Jabooby/Aeris-Control/README.md

# AERISCONTROL
Autonomous sail boat with a multiaxial sail control
