Jabooby/Aeris-Control/UI/README.txt

# Node-RED Flow Import Instructions

This project contains a `flows.json` file that you can import into your own Node-RED environment to replicate the flow and dashboard UI.

Step 1: Run Node-RED

Step 2: http://localhost:1880 OR http://<your-raspberry-pi-IP>:1880

Step 3:click the menu icon in the top right corner (☰)

Step 4: Click on "Import"

Step 5: Click the flows.json file found in this directory
