Jabooby/Aeris-Control/Code/Rp2350/Stepper_control/Diagramme classe.png

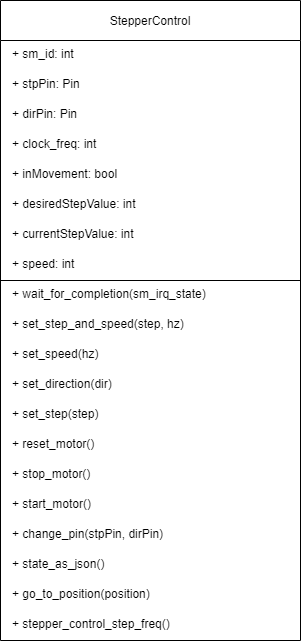
Code/Rp2350/Stepper_control/Diagramme classe.png
