Jabooby/Aeris-Control/Electric/Aeris control electrical plans/Proto_V1/A4988_DRIVER_CARRIER/A4988_STEPPER_MOTOR_DRIVER_CARRIER.step

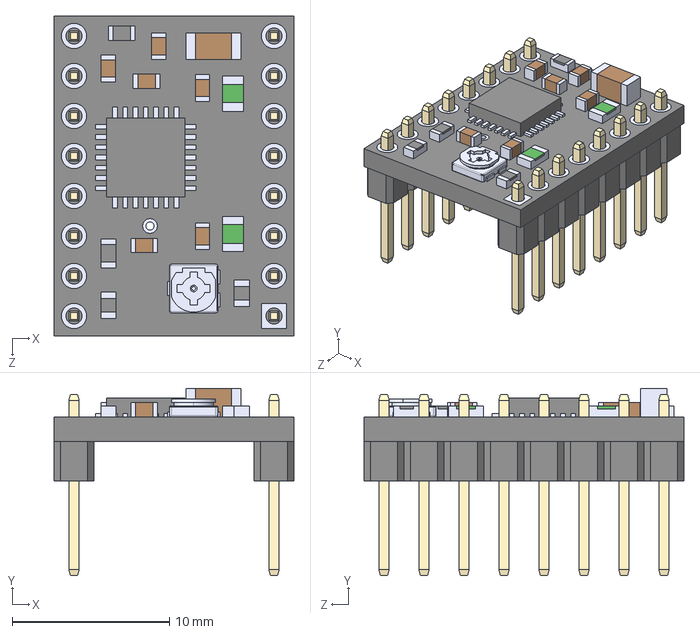
[picture p2: CAD file, 2025-01-29]
Electric/Aeris control electrical plans/Proto_V1/A4988_DRIVER_CARRIER/A4988_STEPPER_MOTOR_DRIVER_CARRIER.step
15.2 x 11.9 x 20.3 mm
