Jabooby/Aeris-Control/Electric/Aeris control electrical plans/symbols/RP2350_KiCad-main/RP2350A-QFN60.step

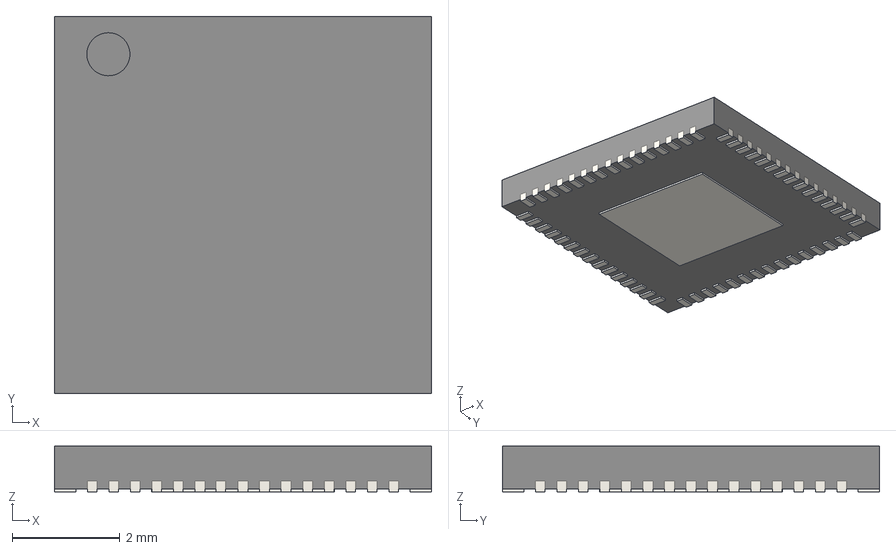
[picture p3: CAD file, 2025-03-01]
Electric/Aeris control electrical plans/symbols/RP2350_KiCad-main/RP2350A-QFN60.step
7.00 x 7.00 x 0.85 mm
