Jabooby/Aeris-Control/Electric/Aeris control electrical plans/symbols/RP2350_KiCad-main/RP2350B-QFN80.step

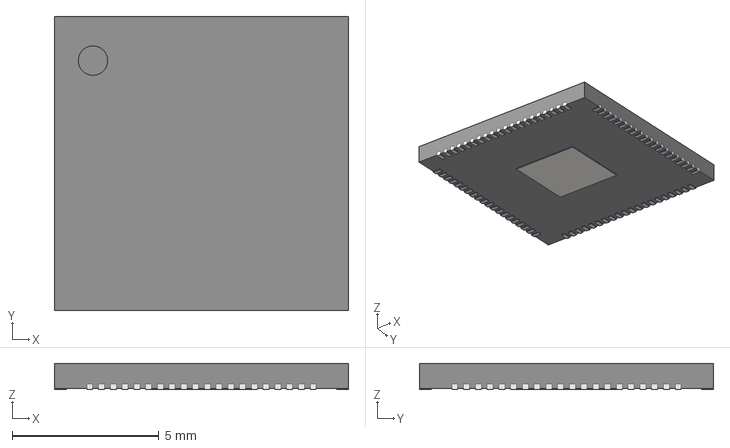
[picture p4: CAD file, 2025-03-01]
Electric/Aeris control electrical plans/symbols/RP2350_KiCad-main/RP2350B-QFN80.step
10.0 x 10.0 x 0.9 mm
