Jabooby/Aeris-Control/Mécanique/Archives/Sail/Sail Shell/Airfoil/airfoil_assembly.stl

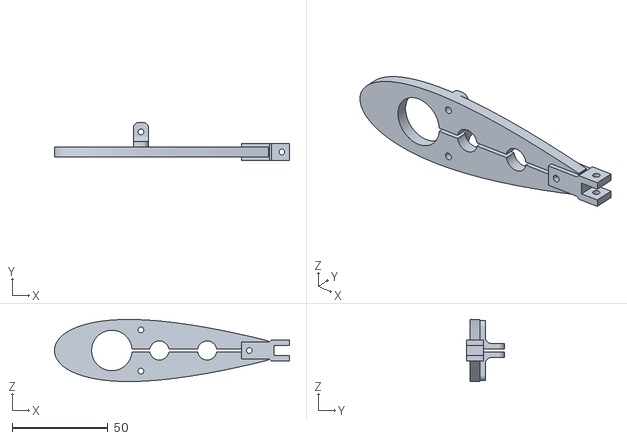
[picture p5: CAD file, 2025-04-02, an earlier design]
Mécanique/Archives/Sail/Sail Shell/Airfoil/airfoil_assembly.stl
123.0 x 20.0 x 32.5
