Jabooby/Aeris-Control/Mécanique/Archives/Fin/Roller_assembly.stl

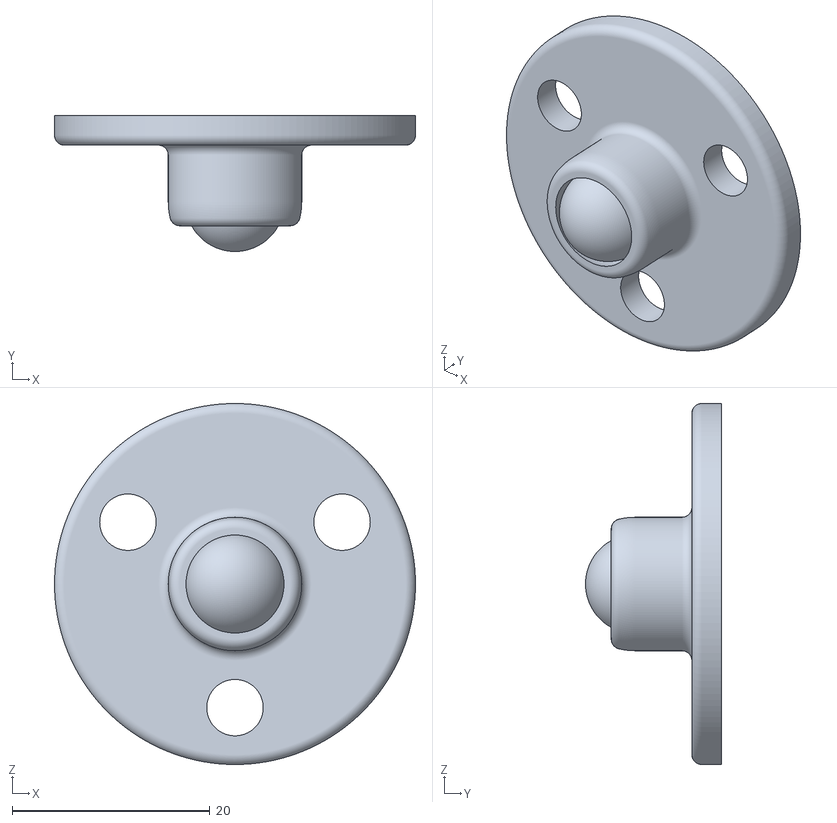
[picture p6: CAD file, 2025-04-02, an earlier design]
Mécanique/Archives/Fin/Roller_assembly.stl
36.5 x 13.8 x 36.5
