Jabooby/Aeris-Control/Mécanique/Archives/Body/Wood_Plank.stl

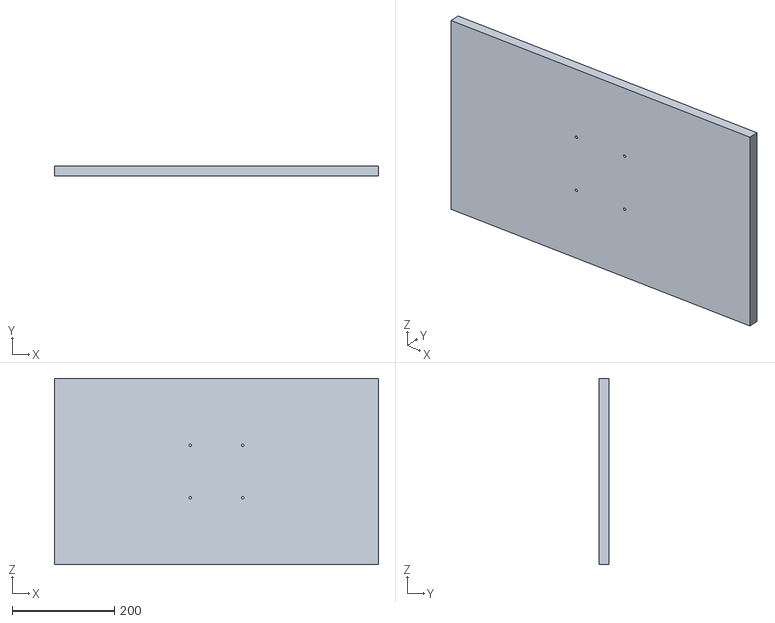
[picture p7: CAD file, 2025-04-02, an earlier design]
Mécanique/Archives/Body/Wood_Plank.stl
635.0 x 19.1 x 365.0
