Jabooby/Aeris-Control/Mécanique/Archives/Electronics_Casing/Floor_1.stl

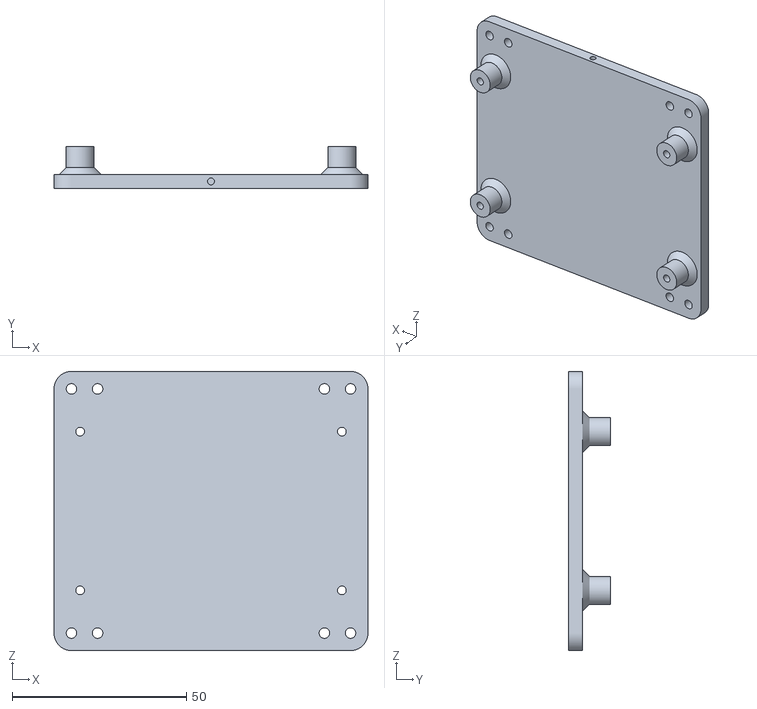
[picture p8: CAD file, 2025-04-02, an earlier design]
Mécanique/Archives/Electronics_Casing/Floor_1.stl
90.0 x 12.0 x 80.0
