Jabooby/Aeris-Control/Mécanique/Archives/Fin/Ball_Holder.stl

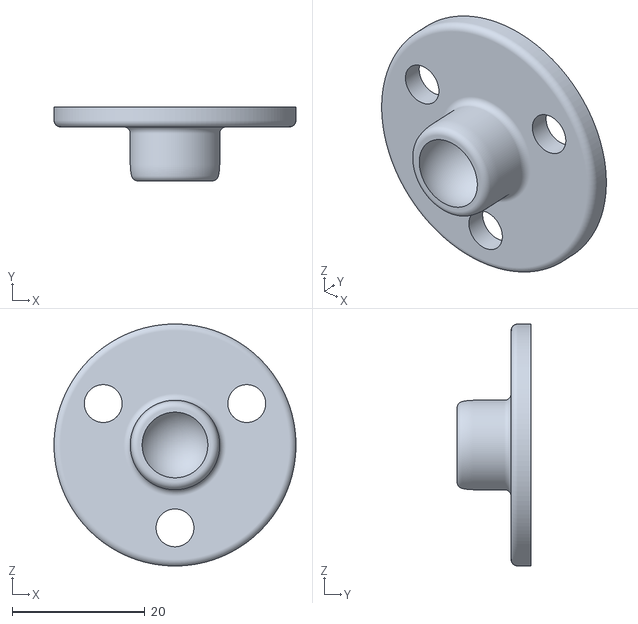
[picture p9: CAD file, 2025-04-02, an earlier design]
Mécanique/Archives/Fin/Ball_Holder.stl
36.5 x 11.2 x 36.5
