Jabooby/Aeris-Control/Mécanique/Archives/IMU_Support/IMU_Casing_Bracket.stl

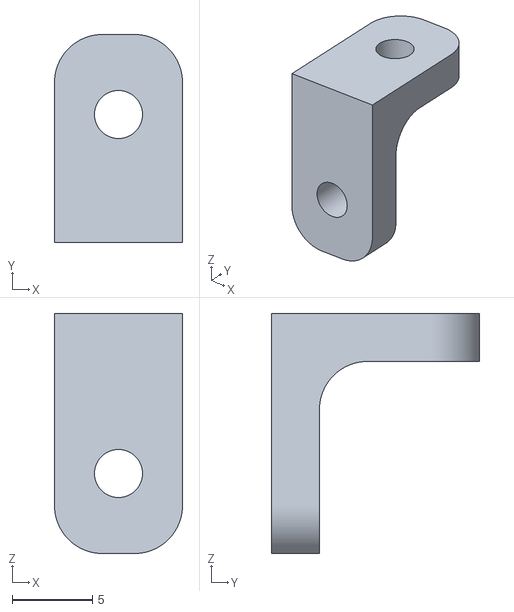
[picture p10: CAD file, 2025-04-02, an earlier design]
Mécanique/Archives/IMU_Support/IMU_Casing_Bracket.stl
8.00 x 13.0 x 15.0
