Jabooby/Aeris-Control/Mécanique/Archives/Mast Holder/Motor_Casing/Motor_Casing.stl

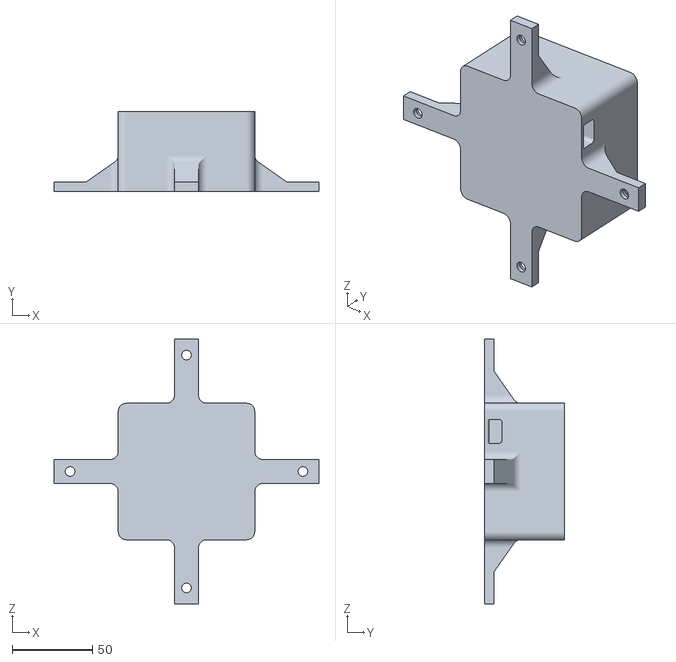
[picture p11: CAD file, 2025-04-02, an earlier design]
Mécanique/Archives/Mast Holder/Motor_Casing/Motor_Casing.stl
165.0 x 50.0 x 165.0
