Jabooby/Aeris-Control/Mécanique/Archives/Mast Holder/Planetary_Gear/(old)Straight_Planetary/Ring.stl

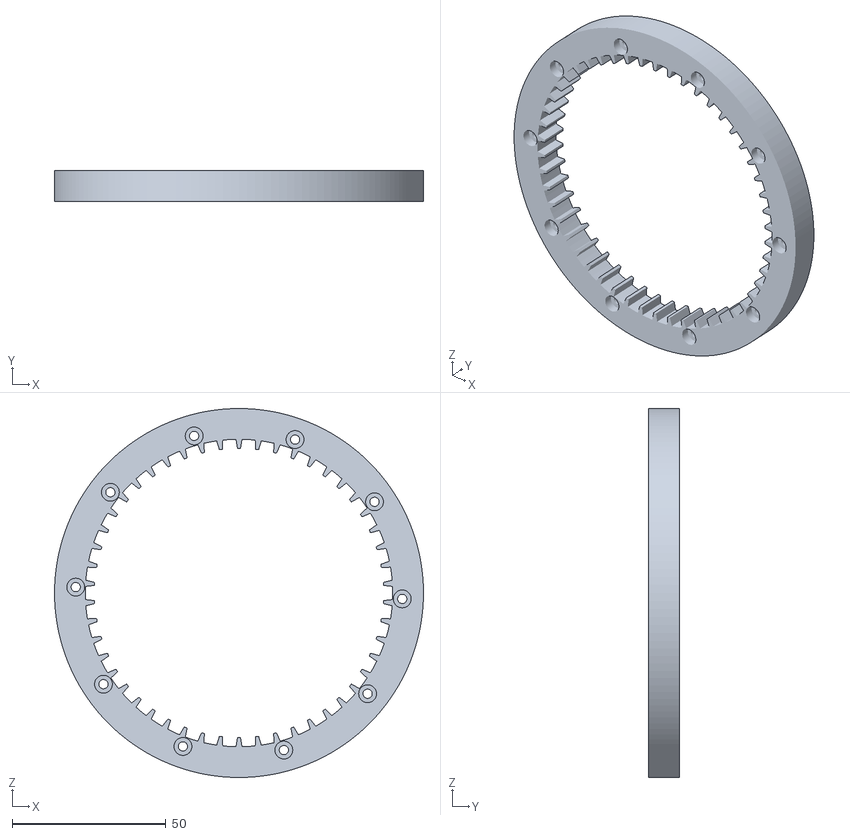
[picture p12: CAD file, 2025-04-02, an earlier design]
Mécanique/Archives/Mast Holder/Planetary_Gear/(old)Straight_Planetary/Ring.stl
120.0 x 10.0 x 120.0
