Jabooby/Aeris-Control/Mécanique/Archives/Mast Holder/Planetary_Gear/Conic_Planetary/ConicGears - Planet.stl

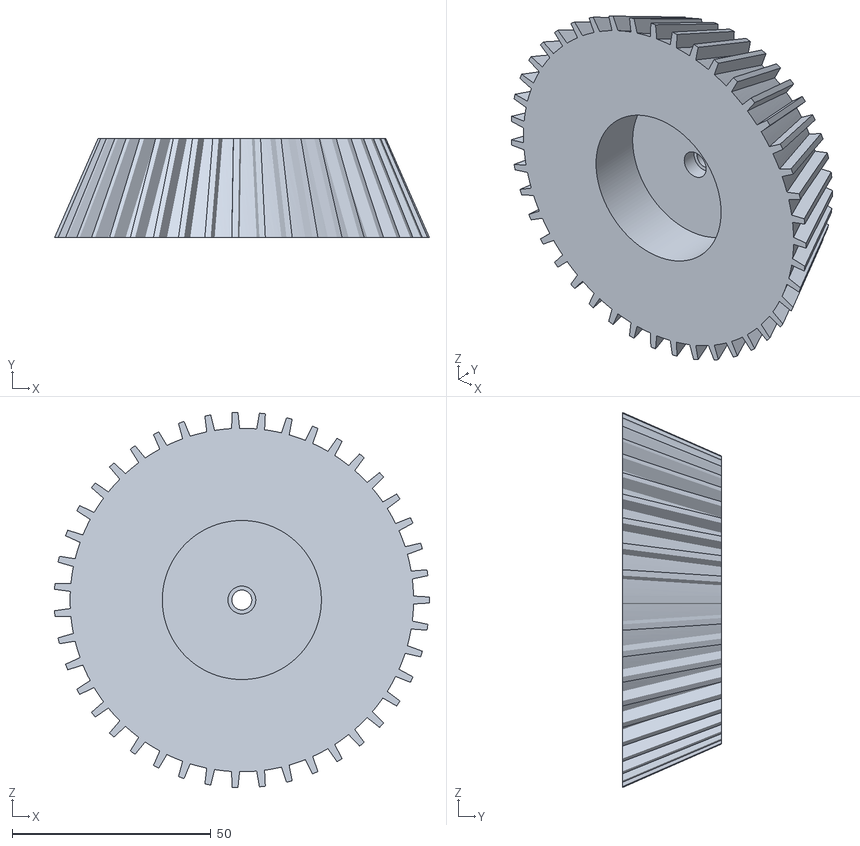
[picture p13: CAD file, 2025-04-02, an earlier design]
Mécanique/Archives/Mast Holder/Planetary_Gear/Conic_Planetary/ConicGears - Planet.stl
94.3 x 25.0 x 94.4
