Jabooby/Aeris-Control/Mécanique/Archives/Mast Holder/Universtal_Joint(Joystick)/Cross.stl

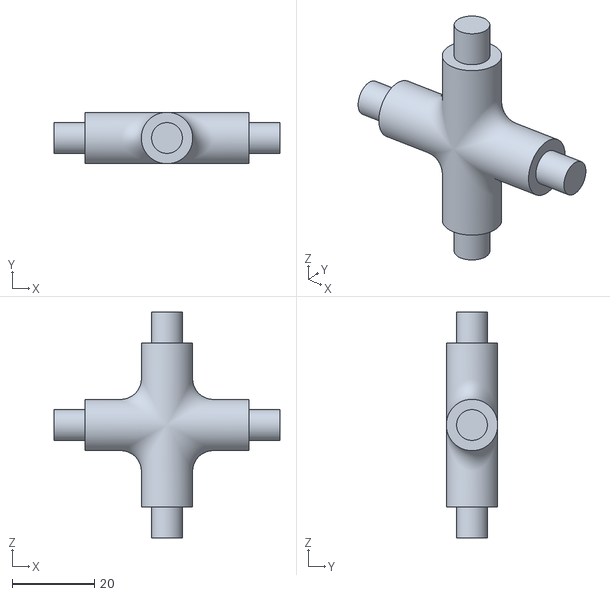
[picture p14: CAD file, 2025-04-02, an earlier design]
Mécanique/Archives/Mast Holder/Universtal_Joint(Joystick)/Cross.stl
55.0 x 12.5 x 55.0
