Jabooby/Aeris-Control/Mécanique/Archives/Rope System/(old)Winch-Pulley system/Guides/Rope holder.stl

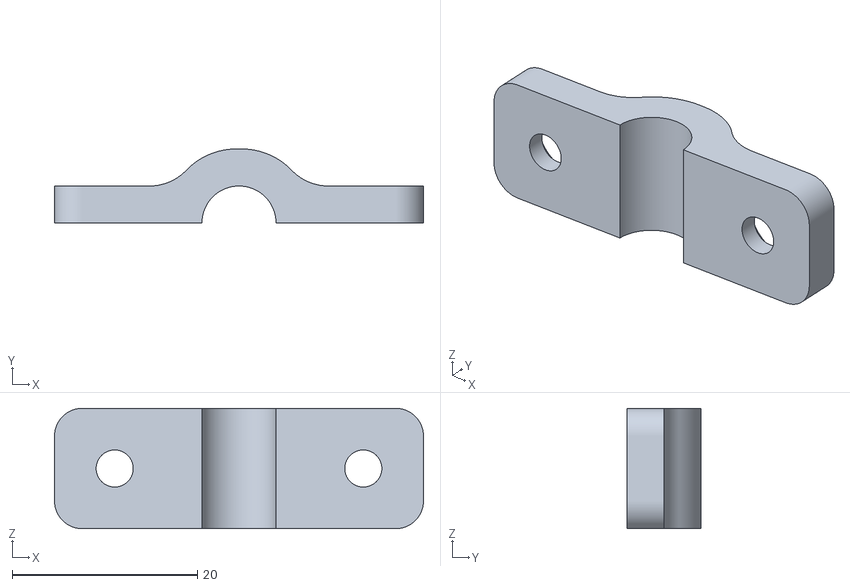
[picture p15: CAD file, 2025-04-02, an earlier design]
Mécanique/Archives/Rope System/(old)Winch-Pulley system/Guides/Rope holder.stl
39.9 x 8.00 x 13.0
