Jabooby/Aeris-Control/Mécanique/Archives/Rope System/(old)Winch-Pulley system/Pulley Parts/Rope_Guide_For_Pulley.stl

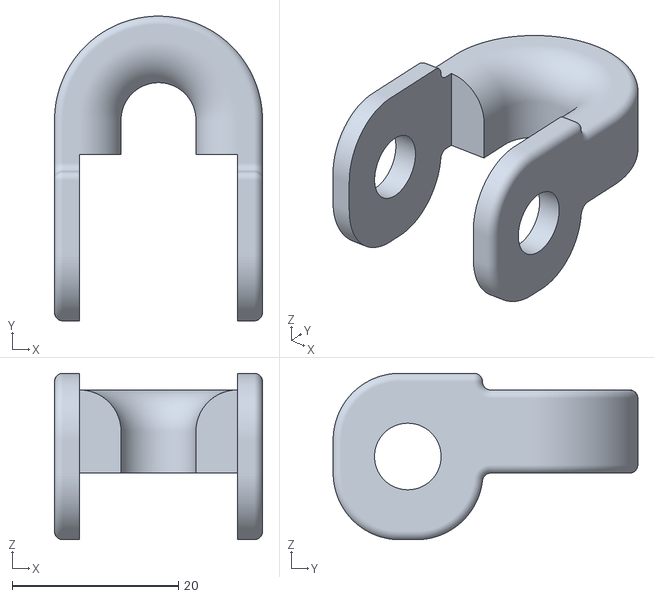
[picture p16: CAD file, 2025-04-02, an earlier design]
Mécanique/Archives/Rope System/(old)Winch-Pulley system/Pulley Parts/Rope_Guide_For_Pulley.stl
25.0 x 36.6 x 20.0
