Jabooby/Aeris-Control/Mécanique/Archives/Rope System/(old)Winch-Pulley system/Spring_pulley/Rope_Guide_For_Pulley.stl

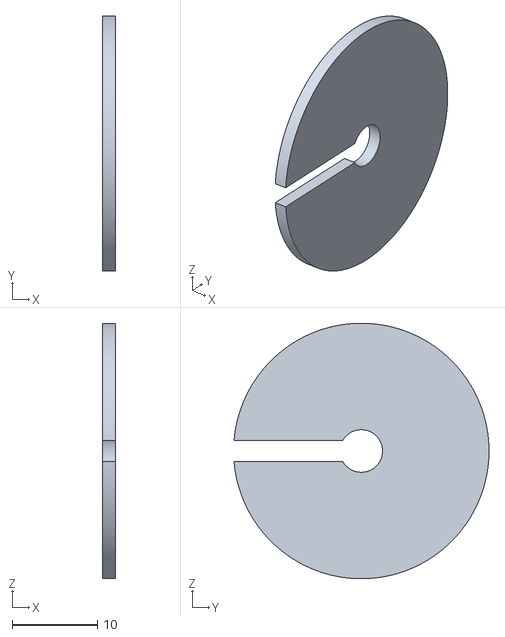
[picture p17: CAD file, 2025-04-02, an earlier design]
Mécanique/Archives/Rope System/(old)Winch-Pulley system/Spring_pulley/Rope_Guide_For_Pulley.stl
1.50 x 29.9 x 30.0
