Jabooby/Aeris-Control/Mécanique/Archives/Rope System/(old)Winch-Pulley system/Winch/Drums/Drum_Large.stl

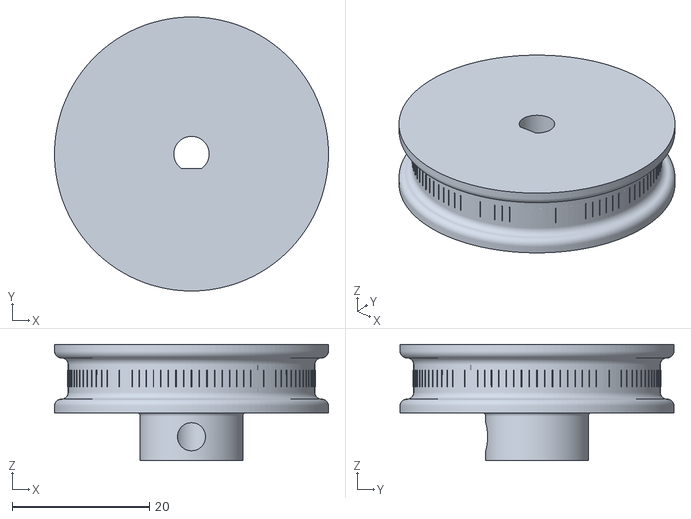
[picture p18: CAD file, 2025-04-02, an earlier design]
Mécanique/Archives/Rope System/(old)Winch-Pulley system/Winch/Drums/Drum_Large.stl
40.0 x 40.0 x 17.0
