Jabooby/Aeris-Control/Mécanique/Archives/Rope System/(old)Winch-Pulley system/Winch/Motor_Bracket.stl

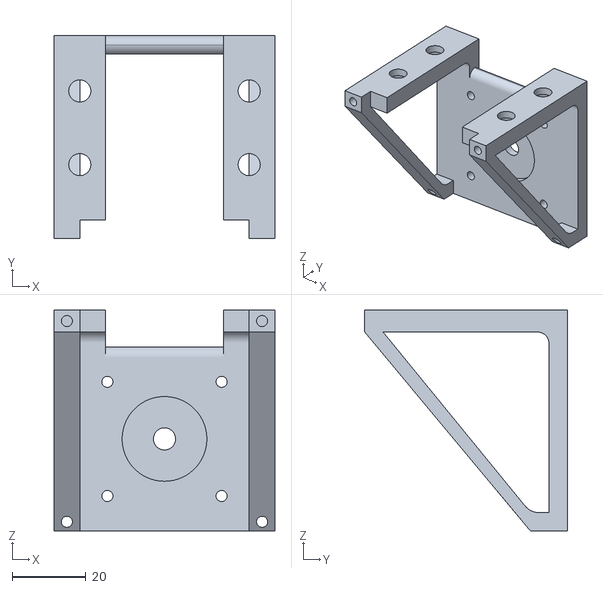
[picture p19: CAD file, 2025-04-02, an earlier design]
Mécanique/Archives/Rope System/(old)Winch-Pulley system/Winch/Motor_Bracket.stl
60.0 x 55.0 x 60.0
