Jabooby/Aeris-Control/(list of files, cad)

Other CAD files:
Mécanique/Archives/Electronics_Casing/Battery_Holder.stl
Mécanique/Archives/Electronics_Casing/Buck_Converter_Bracket.stl
Mécanique/Archives/Electronics_Casing/Floor_0.stl
Mécanique/Archives/Electronics_Casing/Floor_2.stl
Mécanique/Archives/Electronics_Casing/Spacer.stl
Mécanique/Archives/Fin/Fin_representation.stl
Mécanique/Archives/IMU_Support/IMU_Casing.stl
Mécanique/Archives/Mast Holder/Planetary_Gear/(old)Straight_Planetary/Planet.stl
Mécanique/Archives/Mast Holder/Planetary_Gear/(old)Straight_Planetary/Sun.stl
Mécanique/Archives/Mast Holder/Planetary_Gear/Conic_Planetary/ConicGears - Coupler.stl
Mécanique/Archives/Mast Holder/Planetary_Gear/Conic_Planetary/ConicGears - Sun.stl
Mécanique/Archives/Mast Holder/Planetary_Gear/Conic_Planetary/Gearbox_Base.stl
Mécanique/Archives/Mast Holder/Universtal_Joint(Joystick)/Universal_Joint_Bearing.stl
Mécanique/Archives/Rope System/(old)Winch-Pulley system/Pulley Parts/Bolt_representation.stl
Mécanique/Archives/Rope System/(old)Winch-Pulley system/Pulley Parts/Pulley.stl
Mécanique/Archives/Rope System/(old)Winch-Pulley system/Pulley Parts/Pulley_Support_Negative_Angle.stl
Mécanique/Archives/Rope System/(old)Winch-Pulley system/Pulley Parts/Pulley_Support_Positive_Angle.stl
Mécanique/Archives/Rope System/(old)Winch-Pulley system/Spring_pulley/Rope_Pulley.stl
Mécanique/Archives/Rope System/(old)Winch-Pulley system/Spring_pulley/Spring to board.stl
Mécanique/Archives/Rope System/(old)Winch-Pulley system/Winch/Drums/Drum_for_Motor_V_Shape.stl
Mécanique/Archives/Rope System/(old)Winch-Pulley system/Winch/Motor pulley guide.stl
Mécanique/Archives/Rope System/Winch-Spring system/Gearbox/Case/Left_Box.stl
Mécanique/Archives/Rope System/Winch-Spring system/Gearbox/Case/Left_Cover.stl
Mécanique/Archives/Rope System/Winch-Spring system/Gearbox/Case/Right_Box.stl
Mécanique/Archives/Rope System/Winch-Spring system/Gearbox/Case/Right_Cover.stl
Mécanique/Archives/Rope System/Winch-Spring system/Gearbox/Drum.stl
Mécanique/Archives/Rope System/Winch-Spring system/Gearbox/Gears/Driven.stl
Mécanique/Archives/Rope System/Winch-Spring system/Gearbox/Gears/Driver.stl
Mécanique/Archives/Rope System/Winch-Spring system/Gearbox/Gears/Idle.stl
Mécanique/Archives/Rope System/Winch-Spring system/Gearbox/Shaft_modelisation.stl
Mécanique/Archives/Rope System/Winch-Spring system/Gearbox/Spacer.stl
Mécanique/Archives/Sail/Sail Shell/Airfoil/airfoil.stl
Mécanique/Archives/Sail/Sail Shell/Attachement brackets/Airfoil_Batten_Connector.stl
Mécanique/Archives/Sail/Sail Shell/Attachement brackets/Batten_Leech_Connector.stl
Mécanique/Archives/Sail/Sail Shell/Attachement brackets/Mast_Leech_Connector.stl
Mécanique/Archives/Sail/Sail Shell/Battens/Batten_1_smallest.stl
Mécanique/Archives/Sail/Sail Shell/Battens/Batten_2.stl
Mécanique/Archives/Sail/Sail Shell/Battens/Batten_3.stl
Mécanique/Archives/Sail/Sail Shell/Battens/Batten_4.stl
Mécanique/Archives/Sail/Sail Shell/Battens/Batten_5.stl
Mécanique/Archives/Sail/Sail Shell/Leech/angled_leech_wood.stl
Mécanique/Archives/Sail/Sail Shell/Leech/angled_leech_wood_bottom.stl
Mécanique/Archives/Sail/Sail Shell/Leech/angled_leech_wood_top.stl
Mécanique/Archives/Sail/mast.stl
Mécanique/Archives/Wind mesurement/Casing/Bearing saddle.stl
Mécanique/Archives/Wind mesurement/Casing/Bearing.stl
Mécanique/Archives/Wind mesurement/Casing/Encoder_Representation.stl
Mécanique/Archives/Wind mesurement/Heads/Wheather_Vane_Head.stl
