Jabooby/Aeris-Control/Code/Rp2350/Stepper_control/fonction assembly.png

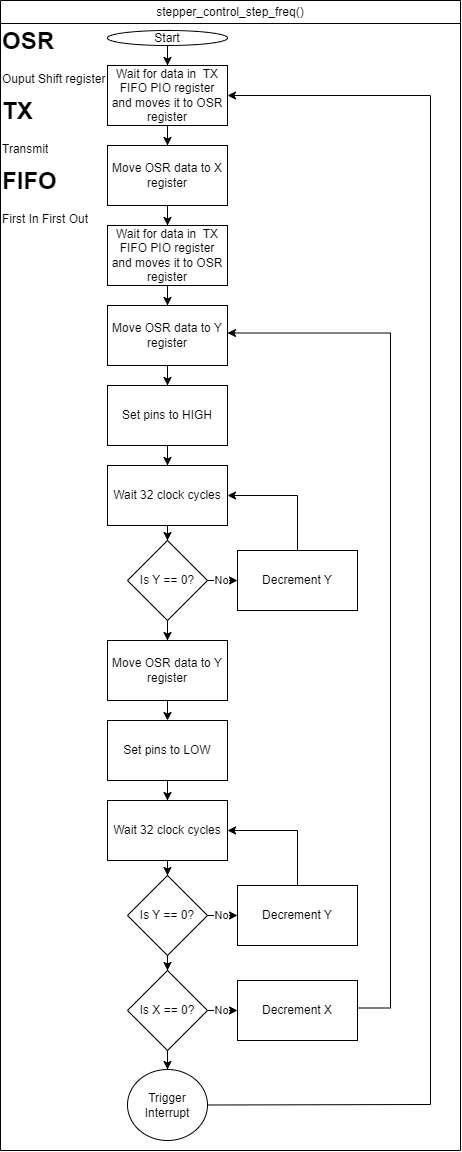
Code/Rp2350/Stepper_control/fonction assembly.png
