Jabooby/Aeris-Control/Electric/Aeris control schematic.pdf

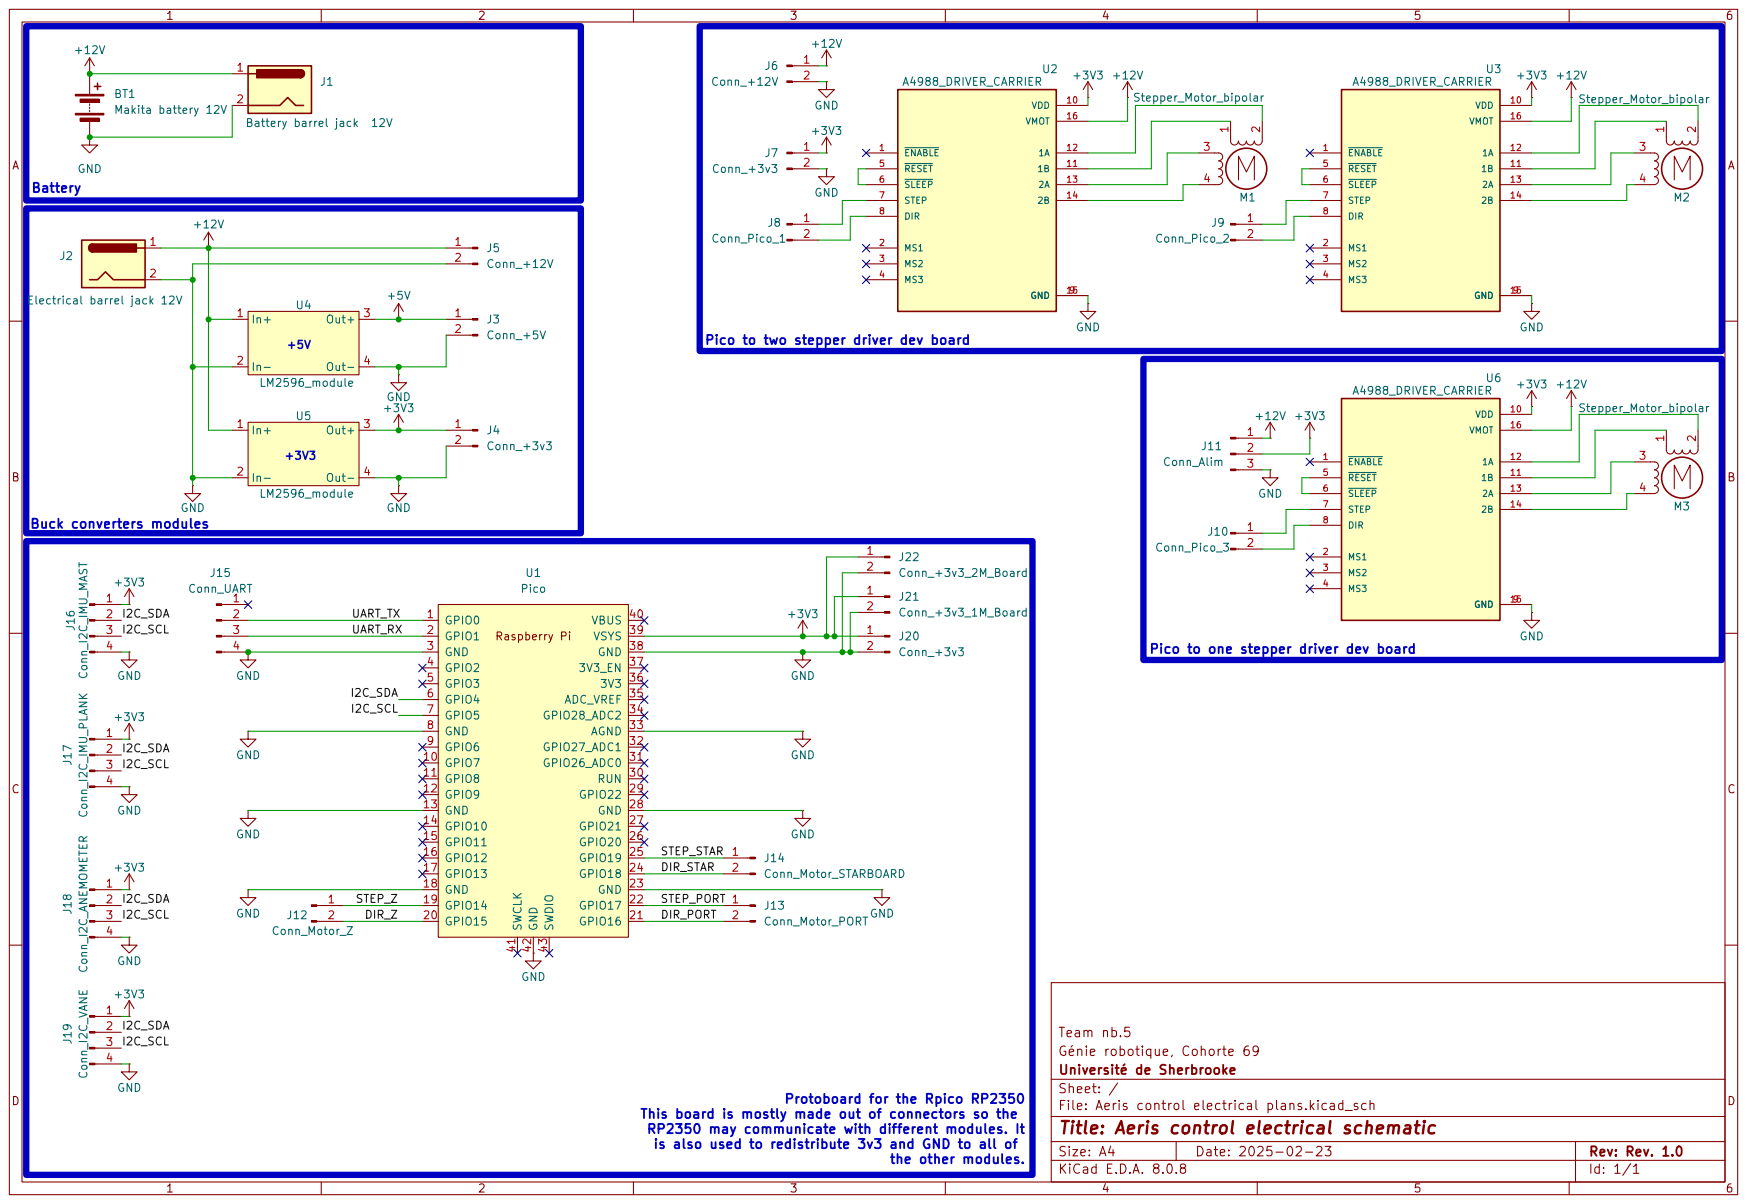
[picture p21: page 1]
