Jabooby/Aeris-Control/Mécanique/Archives/Sail/Sail Shell/wood_laser_cut_800mm.pdf

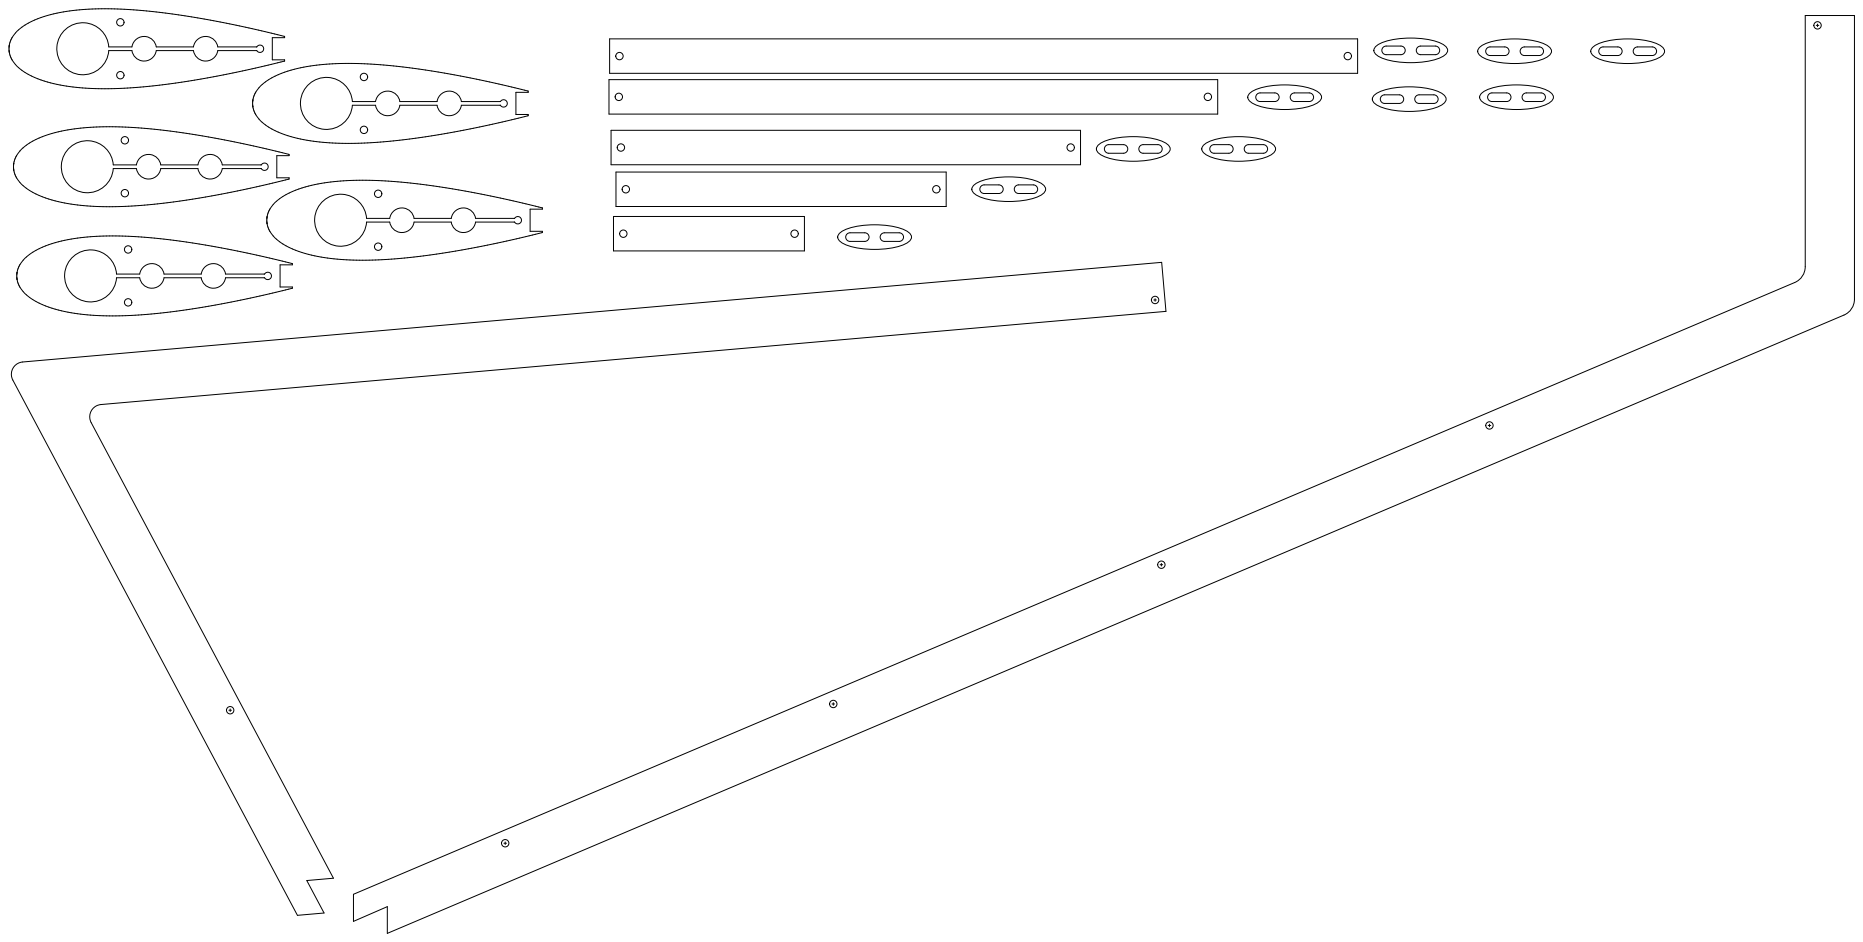
[picture p22: page 1]
