Jabooby/Aeris-Control/Electric/Aeris control electrical plans/Cerbrum_Aeris/Cerbrum_Aeris.kicad_pcb

## KiCad design Electric/Aeris control electrical plans/Cerbrum_Aeris/Cerbrum_Aeris.kicad_pcb (2025-03-12)

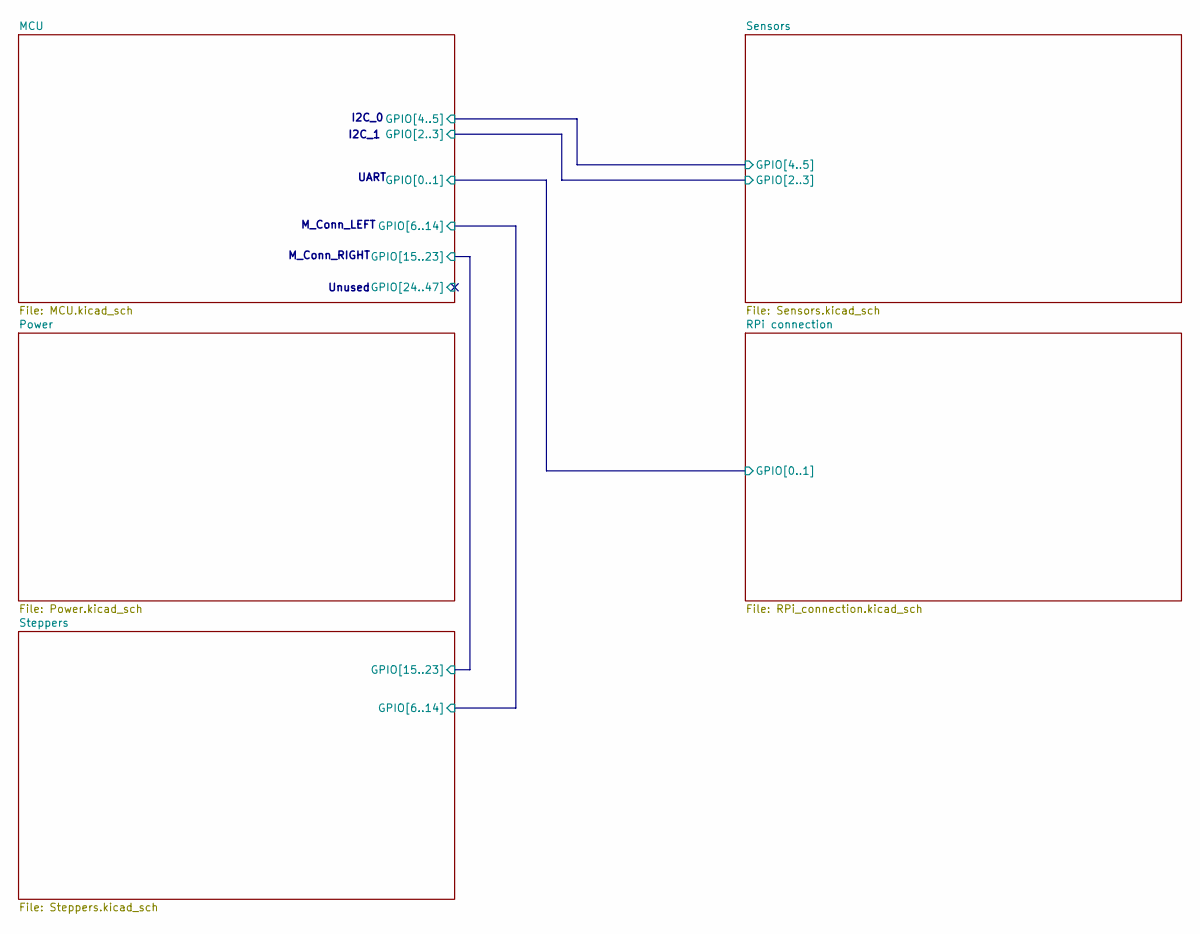
[picture p23: schematic Cerbrum_Aeris.kicad_sch]

Notes on the sheet:
Unused
I2C_1
M_Conn_RIGHT
I2C_0
UART
M_Conn_LEFT

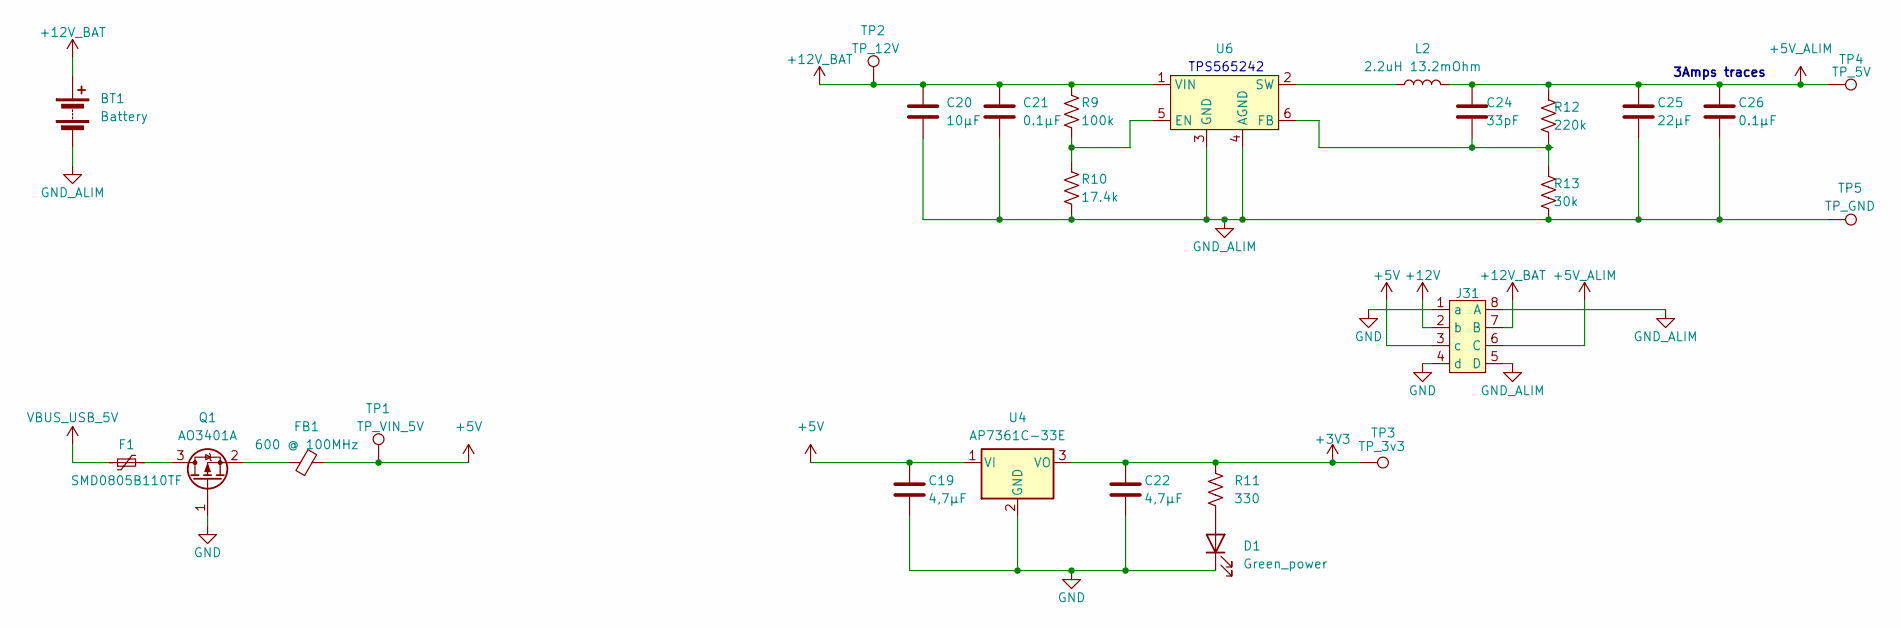
[picture p24: schematic Power.kicad_sch]

Parts:
BT1: Battery; TerminalBlock_Altech_AK300-2_P5.00mm
C19, C22: 4,7µF; C_0805_2012Metric_Pad1.18x1.45mm_HandSolder
C20: 10µF; C_0805_2012Metric_Pad1.18x1.45mm_HandSolder
C21, C26: 0.1µF; C_0603_1608Metric_Pad1.08x0.95mm_HandSolder
C24: 33pF; C_0603_1608Metric_Pad1.08x0.95mm_HandSolder
C25: 22µF; C_0805_2012Metric_Pad1.18x1.45mm_HandSolder
D1: Green_power; D_0805_2012Metric
F1: SMD0805B110TF; Fuse_0805_2012Metric
FB1: 600 @ 100MHz; R_0805_2012Metric_Pad1.20x1.40mm_HandSolder
J31: SJ_Stepper_1-5mm
L2: 2.2uH 13.2mOhm; L_TDK_VLP8040
Q1: AO3401A; SOT-23
R9: 100k; R_0603_1608Metric_Pad0.98x0.95mm_HandSolder
R10: 17.4k; R_0603_1608Metric_Pad0.98x0.95mm_HandSolder
R11: 330; R_0603_1608Metric_Pad0.98x0.95mm_HandSolder
R12: 220k; R_0603_1608Metric_Pad0.98x0.95mm_HandSolder
R13: 30k; R_0603_1608Metric_Pad0.98x0.95mm_HandSolder
TP1: TP_VIN_5V; TestPoint_Pad_D1.0mm
TP2: TP_12V; TestPoint_Pad_D1.0mm
TP3: TP_3v3; TestPoint_Pad_D1.0mm
TP4: TP_5V; TestPoint_Pad_D1.0mm
TP5: TP_GND; TestPoint_Pad_1.0x1.0mm
U4: AP7361C-33E; SOT-223-3_TabPin2
U6: SOT-563

Connections:
+3V3: C22.2, R11.1, TP3.1, U4.3 (VO); also elsewhere on the board
+5V: C19.2, FB1.2, J31.3 (c), TP1.1, U4.1 (VI); also elsewhere on the board
+5V_ALIM: C24.1, C25.1, C26.1, J31.6 (C), L2.2, R12.1, TP4.1; also elsewhere on the board
+12V: J31.2 (b); also elsewhere on the board
+12V_BAT: BT1.1 (+), C20.1, C21.1, J31.7 (B), R9.1, TP2.1, U6.1 (VIN); also elsewhere on the board
GND: C19.1, C22.1, D1.1 (K), J31.1 (a), J31.4 (d), Q1.1 (G), U4.2 (GND); also elsewhere on the board
GND_ALIM: BT1.2 (-), C20.2, C21.2, C25.2, C26.2, J31.5 (D), J31.8 (A), R10.2, R13.2, TP5.1, U6.3 (GND), U6.4 (AGND); also elsewhere on the board
unnamed: D1.2 (A), R11.2
unnamed: F1.2, Q1.3 (D)
unnamed: FB1.1, Q1.2 (S)
unnamed: R9.2, R10.1, U6.5 (EN)
unnamed: C24.2, R12.2, R13.1, U6.6 (FB)
unnamed: L2.1, U6.2 (SW)
VBUS_USB_5V: F1.1; also elsewhere on the board

Notes on the sheet:
TPS565242
3Amps traces

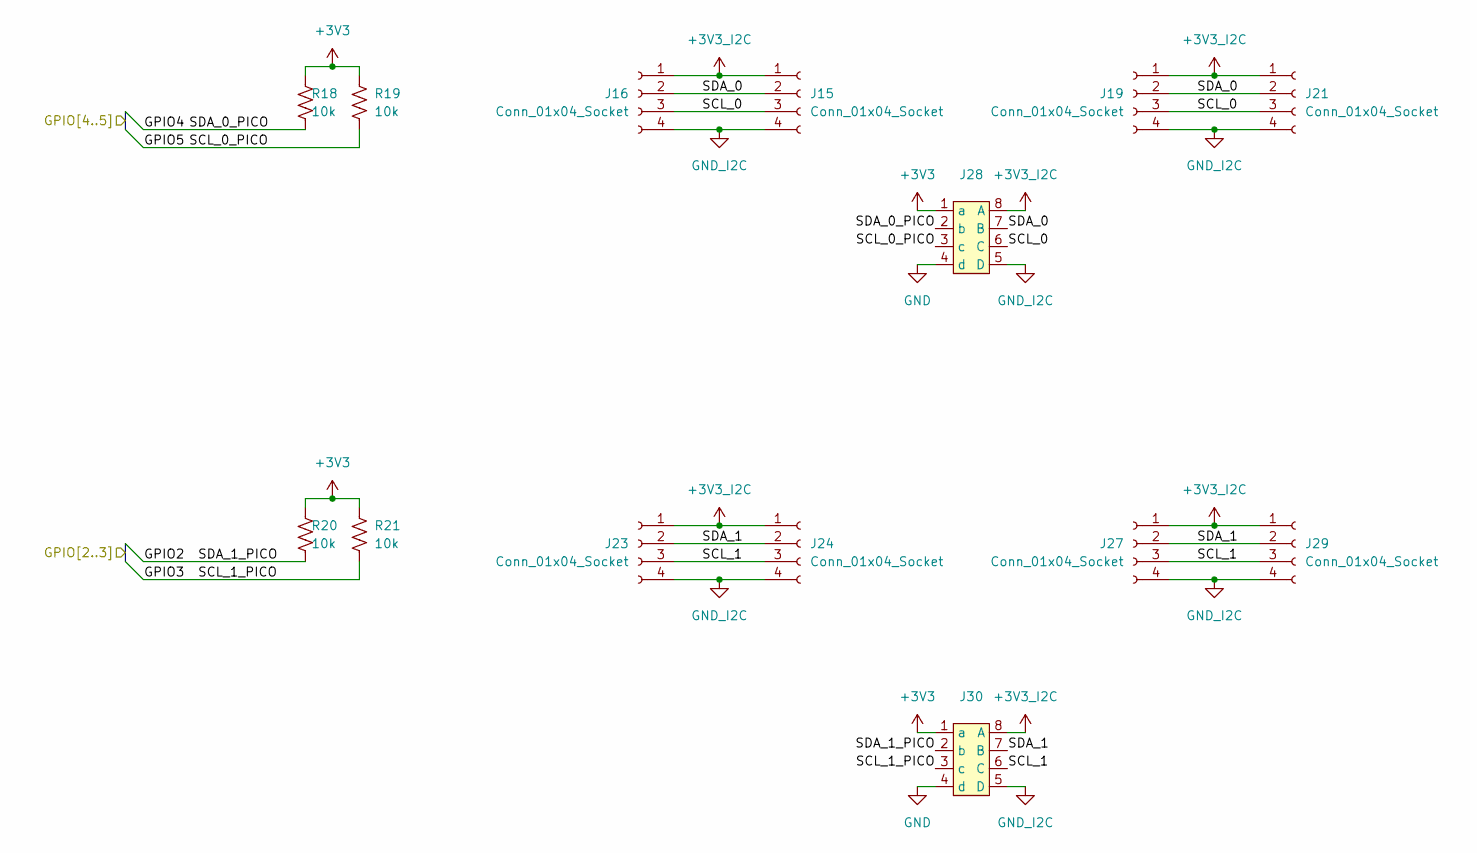
[picture p25: schematic Sensors.kicad_sch]

Parts:
J15, J16, J19, J21, J23, J24, J27, J29: Conn_01x04_Socket; PinSocket_1x04_P2.54mm_Vertical
J28, J30: SJ_Stepper_1-5mm
R18, R19, R20, R21: 10k; R_0603_1608Metric

Connections:
+3V3: J28.1 (a), J30.1 (a), R18.1, R19.1, R20.1, R21.1; also elsewhere on the board
+3V3_I2C: J15.1, J16.1, J19.1, J21.1, J23.1, J24.1, J27.1, J28.8 (A), J29.1, J30.8 (A)
/MCU/GPIO2: J30.2 (b), R20.2; also elsewhere on the board
/MCU/GPIO3: J30.3 (c), R21.2; also elsewhere on the board
/MCU/GPIO4: J28.2 (b), R18.2; also elsewhere on the board
/MCU/GPIO5: J28.3 (c), R19.2; also elsewhere on the board
/Sensors/SCL_0: J15.3, J16.3, J19.3, J21.3, J28.6 (C)
/Sensors/SCL_1: J23.3, J24.3, J27.3, J29.3, J30.6 (C)
/Sensors/SDA_0: J15.2, J16.2, J19.2, J21.2, J28.7 (B)
/Sensors/SDA_1: J23.2, J24.2, J27.2, J29.2, J30.7 (B)
GND: J28.4 (d), J30.4 (d); also elsewhere on the board
GND_I2C: J15.4, J16.4, J19.4, J21.4, J23.4, J24.4, J27.4, J28.5 (D), J29.4, J30.5 (D)

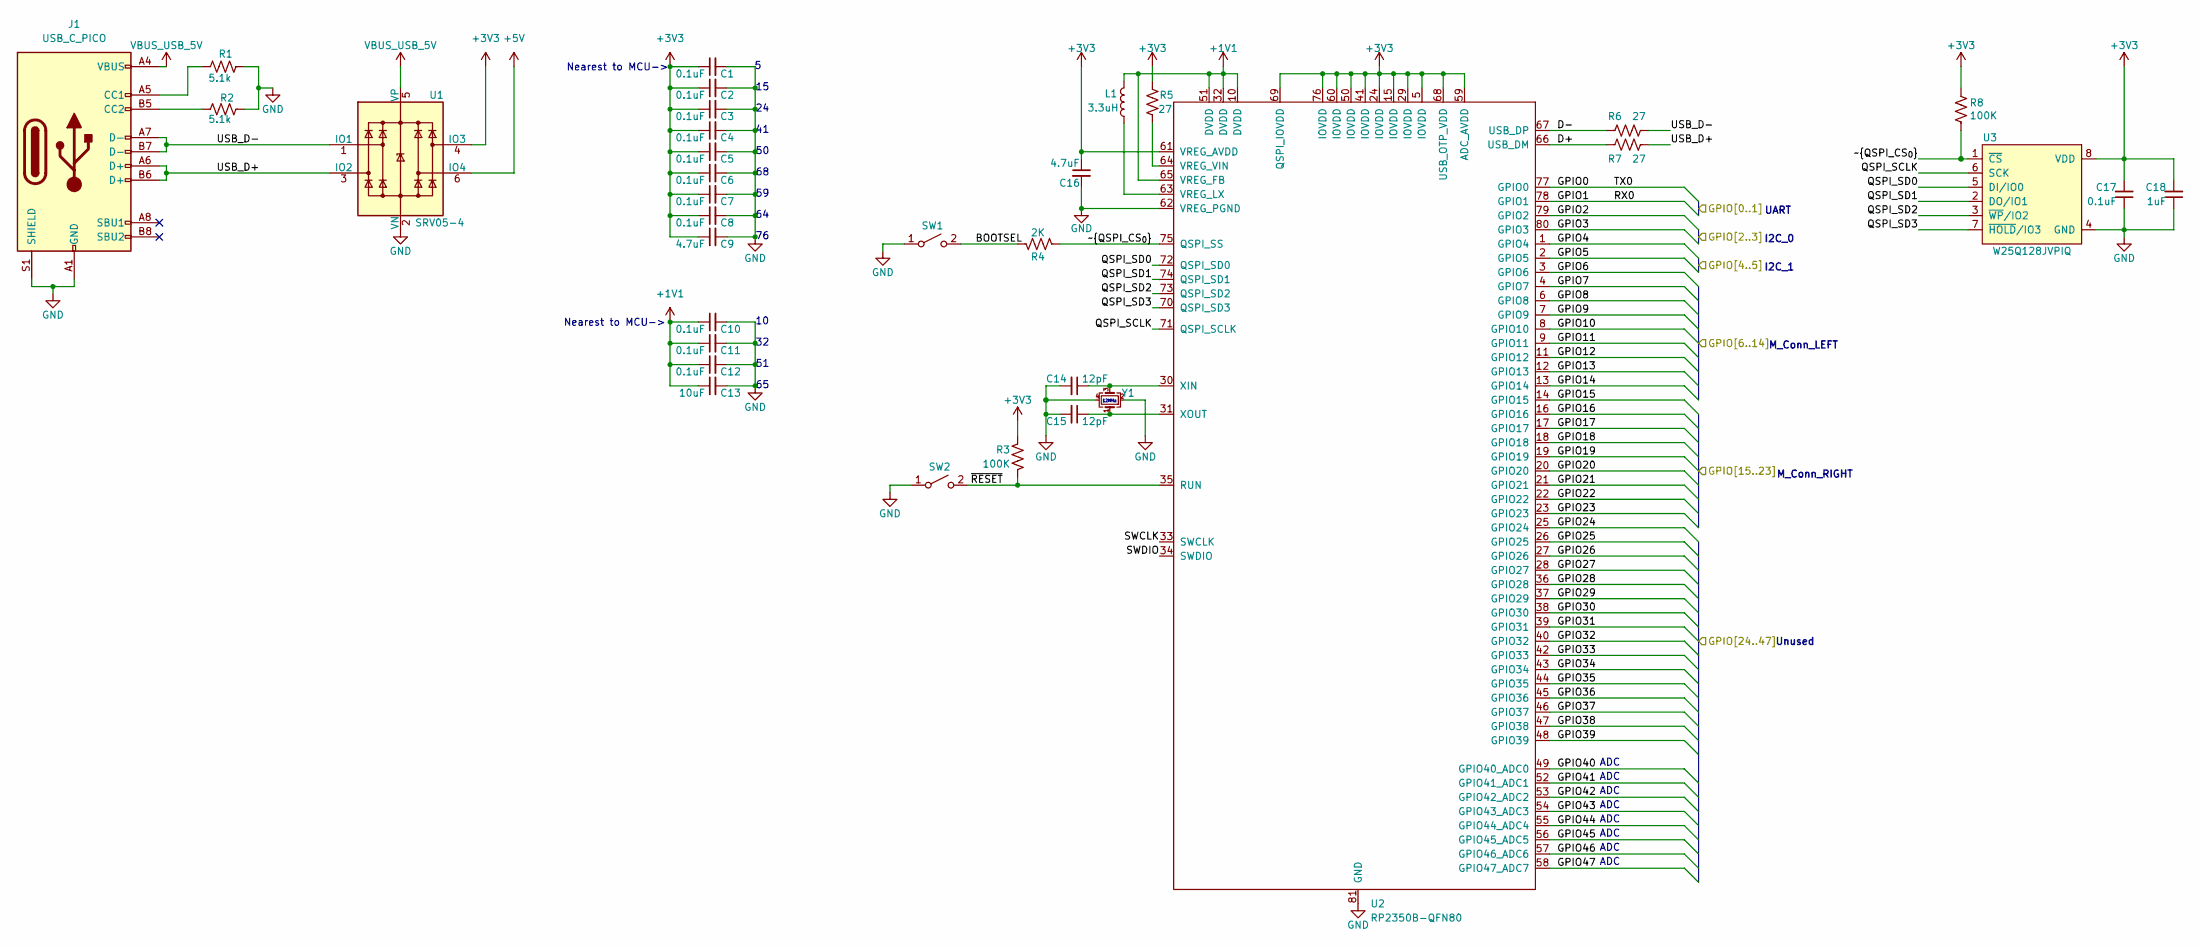
[picture p26: schematic MCU.kicad_sch]

Parts:
C1, C2, C3, C4, C5, C6, C7, C8, C10, C11, C12, C17: 0.1uF; C_0603_1608Metric
C9, C16: 4.7uF; C_0603_1608Metric
C13: 10uF; C_0603_1608Metric
C14, C15: 12pF; C_0603_1608Metric
C18: 1uF; C_0603_1608Metric
J1: USB_C_PICO; USB_C_Receptacle_G-Switch_GT-USB-7010ASV
L1: 3.3uH; R_0805_2012Metric
R1, R2: 5.1k; R_0603_1608Metric_Pad0.98x0.95mm_HandSolder
R3, R8: 100K; R_0603_1608Metric
R4: 2K; R_0603_1608Metric
R5, R6, R7: 27; R_0603_1608Metric
SW1: SW_BOOTSEL; SW_SPST_B3U-1000P; LCSC C561514
SW2: SW_RESET; SW_SPST_B3U-1000P; LCSC C561514
U1: SRV05-4; SOT-23-6
U2: RP2350B-QFN80; QFN-80-1EP_10x10mm_P0.4mm_EP3.4x3.4mm_ThermalVias
U3: W25Q128JVPIQ; WSON-8-1EP_6x5mm_P1.27mm_EP3.4x4mm; LCSC C190862
Y1: CM4012M00012001; Crystal_SMD_2520-4Pin_2.5x2.0mm; LCSC C7294611

Connections:
+1V1: C10.1, C11.1, C12.1, C13.1, L1.2, U2.10 (DVDD), U2.32 (DVDD), U2.51 (DVDD), U2.65 (VREG_FB)
+3V3: C1.1, C2.1, C3.1, C4.1, C5.1, C6.1, C7.1, C8.1, C9.1, C16.1, C17.2, C18.2, R3.1, R5.1, R8.2, U1.4 (IO3), U2.5 (IOVDD), U2.15 (IOVDD), U2.24 (IOVDD), U2.29 (IOVDD), U2.41 (IOVDD), U2.50 (IOVDD), U2.59 (ADC_AVDD), U2.60 (IOVDD), U2.61 (VREG_AVDD), U2.68 (USB_OTP_VDD), U2.69 (QSPI_IOVDD), U2.76 (IOVDD), U3.8 (VDD); also elsewhere on the board
+5V: U1.6 (IO4); also elsewhere on the board
/MCU/BOOTSEL: R4.2, SW1.2 (B); also elsewhere on the board
/MCU/D+: R7.2, U2.66 (USB_DM)
/MCU/D-: R6.1, U2.67 (USB_DP)
/MCU/GPIO0: U2.77 (GPIO0); also elsewhere on the board
/MCU/GPIO1: U2.78 (GPIO1); also elsewhere on the board
/MCU/GPIO2: U2.79 (GPIO2); also elsewhere on the board
/MCU/GPIO3: U2.80 (GPIO3); also elsewhere on the board
/MCU/GPIO4: U2.1 (GPIO4); also elsewhere on the board
/MCU/GPIO5: U2.2 (GPIO5); also elsewhere on the board
/MCU/GPIO6: U2.3 (GPIO6); also elsewhere on the board
/MCU/GPIO7: U2.4 (GPIO7); also elsewhere on the board
/MCU/GPIO8: U2.6 (GPIO8); also elsewhere on the board
/MCU/GPIO9: U2.7 (GPIO9); also elsewhere on the board
/MCU/GPIO10: U2.8 (GPIO10); also elsewhere on the board
/MCU/GPIO11: U2.9 (GPIO11); also elsewhere on the board
/MCU/GPIO12: U2.11 (GPIO12); also elsewhere on the board
/MCU/GPIO13: U2.12 (GPIO13); also elsewhere on the board
/MCU/GPIO14: U2.13 (GPIO14); also elsewhere on the board
/MCU/GPIO15: U2.14 (GPIO15); also elsewhere on the board
/MCU/GPIO16: U2.16 (GPIO16); also elsewhere on the board
/MCU/GPIO17: U2.17 (GPIO17); also elsewhere on the board
/MCU/GPIO18: U2.18 (GPIO18); also elsewhere on the board
/MCU/GPIO19: U2.19 (GPIO19); also elsewhere on the board
/MCU/GPIO20: U2.20 (GPIO20); also elsewhere on the board
/MCU/GPIO21: U2.21 (GPIO21); also elsewhere on the board
/MCU/GPIO22: U2.22 (GPIO22); also elsewhere on the board
/MCU/GPIO23: U2.23 (GPIO23); also elsewhere on the board
/MCU/GPIO24: U2.25 (GPIO24)
/MCU/GPIO25: U2.26 (GPIO25)
/MCU/GPIO26: U2.27 (GPIO26)
/MCU/GPIO27: U2.28 (GPIO27)
/MCU/GPIO28: U2.36 (GPIO28)
/MCU/GPIO29: U2.37 (GPIO29)
/MCU/GPIO30: U2.38 (GPIO30)
/MCU/GPIO31: U2.39 (GPIO31)
/MCU/GPIO32: U2.40 (GPIO32)
/MCU/GPIO33: U2.42 (GPIO33)
/MCU/GPIO34: U2.43 (GPIO34)
/MCU/GPIO35: U2.44 (GPIO35)
/MCU/GPIO36: U2.45 (GPIO36)
/MCU/GPIO37: U2.46 (GPIO37)
/MCU/GPIO38: U2.47 (GPIO38)
/MCU/GPIO39: U2.48 (GPIO39)
/MCU/GPIO40: U2.49 (GPIO40_ADC0)
/MCU/GPIO41: U2.52 (GPIO41_ADC1)
/MCU/GPIO42: U2.53 (GPIO42_ADC2)
/MCU/GPIO43: U2.54 (GPIO43_ADC3)
/MCU/GPIO44: U2.55 (GPIO44_ADC4)
/MCU/GPIO45: U2.56 (GPIO45_ADC5)
/MCU/GPIO46: U2.57 (GPIO46_ADC6)
/MCU/GPIO47: U2.58 (GPIO47_ADC7)
/MCU/QSPI_SCLK: U2.71 (QSPI_SCLK), U3.6 (SCK)
/MCU/QSPI_SD0: U2.72 (QSPI_SD0), U3.5 (DI/IO0)
/MCU/QSPI_SD1: U2.74 (QSPI_SD1), U3.2 (DO/IO1)
/MCU/QSPI_SD2: U2.73 (QSPI_SD2), U3.3 (~WP/IO2)
/MCU/QSPI_SD3: U2.70 (QSPI_SD3), U3.7 (~HOLD/IO3)
/MCU/SWCLK: U2.33 (SWCLK)
/MCU/SWDIO: U2.34 (SWDIO)
/MCU/USB_D+: J1.A6 (D+), J1.B6 (D+), R7.1, U1.3 (IO2)
/MCU/USB_D-: J1.A7 (D-), J1.B7 (D-), R6.2, U1.1 (IO1)
/MCU/~QSPI_CS_{0}: R4.1, R8.1, U2.75 (QSPI_SS), U3.1 (~CS)
/MCU/~RESET: R3.2, SW2.2 (B), U2.35 (RUN); also elsewhere on the board
GND: C1.2, C2.2, C3.2, C4.2, C5.2, C6.2, C7.2, C8.2, C9.2, C10.2, C11.2, C12.2, C13.2, C14.2, C15.2, C16.2, C17.1, C18.1, J1.A1 (GND), J1.A12 (GND), J1.B1 (GND), J1.B12 (GND), J1.S1 (SHIELD), R1.2, R2.2, SW1.1 (A), SW2.1 (A), U1.2 (VN), U2.62 (VREG_PGND), U2.81 (GND), U3.4 (GND), U3.9 (GND), Y1.2, Y1.4; also elsewhere on the board
unnamed: J1.A5 (CC1), R1.1
unnamed: J1.B5 (CC2), R2.1
unnamed: L1.1, U2.63 (VREG_LX)
unnamed: R5.2, U2.64 (VREG_VIN)
unnamed: C14.1, U2.30 (XIN), Y1.3
unnamed: C15.1, U2.31 (XOUT), Y1.1
VBUS_USB_5V: J1.A4 (VBUS), J1.A9 (VBUS), J1.B4 (VBUS), J1.B9 (VBUS), U1.5 (VP); also elsewhere on the board

Notes on the sheet:
Nearest to MCU->
M_Conn_LEFT
ADC
Unused
I2C_0
M_Conn_RIGHT
12MHz
I2C_1
UART

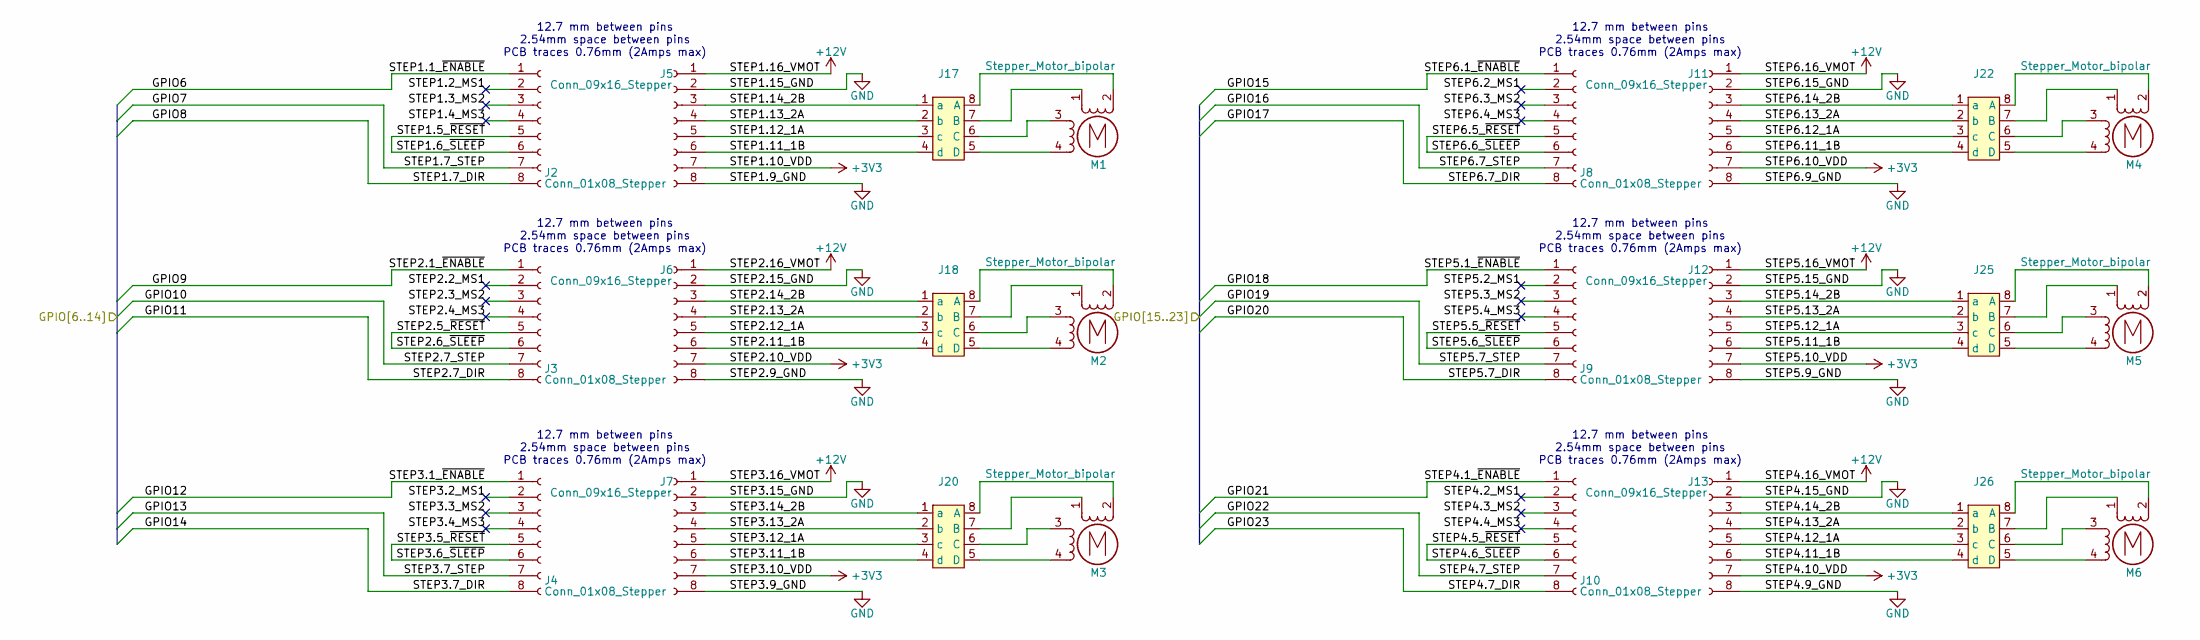
[picture p27: schematic Steppers.kicad_sch]

Parts:
J2, J3, J4, J8, J9, J10: Conn_01x08_Stepper; PinSocket_1x08_P2.54mm_Vertical_SMD_Pin1Left
J5, J6, J7, J11, J12, J13: Conn_09x16_Stepper; PinSocket_1x08_P2.54mm_Vertical_SMD_Pin1Left
J17, J18, J20, J22, J25, J26: SJ_Stepper_1-5mm
M1, M2, M3, M4, M5, M6: Stepper_Motor_bipolar; PinSocket_1x04_P2.54mm_Vertical

Connections:
+3V3: J5.7, J6.7, J7.7, J11.7, J12.7, J13.7; also elsewhere on the board
+12V: J5.1, J6.1, J7.1, J11.1, J12.1, J13.1; also elsewhere on the board
/MCU/GPIO6: J2.1; also elsewhere on the board
/MCU/GPIO7: J2.7; also elsewhere on the board
/MCU/GPIO8: J2.8; also elsewhere on the board
/MCU/GPIO9: J3.1; also elsewhere on the board
/MCU/GPIO10: J3.7; also elsewhere on the board
/MCU/GPIO11: J3.8; also elsewhere on the board
/MCU/GPIO12: J4.1; also elsewhere on the board
/MCU/GPIO13: J4.7; also elsewhere on the board
/MCU/GPIO14: J4.8; also elsewhere on the board
/MCU/GPIO15: J8.1; also elsewhere on the board
/MCU/GPIO16: J8.7; also elsewhere on the board
/MCU/GPIO17: J8.8; also elsewhere on the board
/MCU/GPIO18: J9.1; also elsewhere on the board
/MCU/GPIO19: J9.7; also elsewhere on the board
/MCU/GPIO20: J9.8; also elsewhere on the board
/MCU/GPIO21: J10.1; also elsewhere on the board
/MCU/GPIO22: J10.7; also elsewhere on the board
/MCU/GPIO23: J10.8; also elsewhere on the board
/Steppers/STEP1.2_MS1: J2.2
/Steppers/STEP1.3_MS2: J2.3
/Steppers/STEP1.4_MS3: J2.4
/Steppers/STEP1.5_~RESET: J2.5, J2.6
/Steppers/STEP1.11_1B: J5.6, J17.4 (d)
/Steppers/STEP1.12_1A: J5.5, J17.3 (c)
/Steppers/STEP1.13_2A: J5.4, J17.2 (b)
/Steppers/STEP1.14_2B: J5.3, J17.1 (a)
/Steppers/STEP2.2_MS1: J3.2
/Steppers/STEP2.3_MS2: J3.3
/Steppers/STEP2.4_MS3: J3.4
/Steppers/STEP2.5_~RESET: J3.5, J3.6
/Steppers/STEP2.11_1B: J6.6, J18.4 (d)
/Steppers/STEP2.12_1A: J6.5, J18.3 (c)
/Steppers/STEP2.13_2A: J6.4, J18.2 (b)
/Steppers/STEP2.14_2B: J6.3, J18.1 (a)
/Steppers/STEP3.2_MS1: J4.2
/Steppers/STEP3.3_MS2: J4.3
/Steppers/STEP3.4_MS3: J4.4
/Steppers/STEP3.5_~RESET: J4.5, J4.6
/Steppers/STEP3.11_1B: J7.6, J20.4 (d)
/Steppers/STEP3.12_1A: J7.5, J20.3 (c)
/Steppers/STEP3.13_2A: J7.4, J20.2 (b)
/Steppers/STEP3.14_2B: J7.3, J20.1 (a)
/Steppers/STEP4.2_MS1: J10.2
/Steppers/STEP4.3_MS2: J10.3
/Steppers/STEP4.4_MS3: J10.4
/Steppers/STEP4.5_~RESET: J10.5, J10.6
/Steppers/STEP4.11_1B: J13.6, J26.4 (d)
/Steppers/STEP4.12_1A: J13.5, J26.3 (c)
/Steppers/STEP4.13_2A: J13.4, J26.2 (b)
/Steppers/STEP4.14_2B: J13.3, J26.1 (a)
/Steppers/STEP5.2_MS1: J9.2
/Steppers/STEP5.3_MS2: J9.3
/Steppers/STEP5.4_MS3: J9.4
/Steppers/STEP5.5_~RESET: J9.5, J9.6
/Steppers/STEP5.11_1B: J12.6, J25.4 (d)
/Steppers/STEP5.12_1A: J12.5, J25.3 (c)
/Steppers/STEP5.13_2A: J12.4, J25.2 (b)
/Steppers/STEP5.14_2B: J12.3, J25.1 (a)
/Steppers/STEP6.2_MS1: J8.2
/Steppers/STEP6.3_MS2: J8.3
/Steppers/STEP6.4_MS3: J8.4
/Steppers/STEP6.5_~RESET: J8.5, J8.6
/Steppers/STEP6.11_1B: J11.6, J22.4 (d)
/Steppers/STEP6.12_1A: J11.5, J22.3 (c)
/Steppers/STEP6.13_2A: J11.4, J22.2 (b)
/Steppers/STEP6.14_2B: J11.3, J22.1 (a)
GND: J5.2, J5.8, J6.2, J6.8, J7.2, J7.8, J11.2, J11.8, J12.2, J12.8, J13.2, J13.8; also elsewhere on the board
unnamed: J17.8 (A), M1.2 (-)
unnamed: J17.7 (B), M1.1
unnamed: J17.6 (C), M1.3
unnamed: J17.5 (D), M1.4
unnamed: J18.8 (A), M2.2 (-)
unnamed: J18.7 (B), M2.1
unnamed: J18.6 (C), M2.3
unnamed: J18.5 (D), M2.4
unnamed: J20.8 (A), M3.2 (-)
unnamed: J20.7 (B), M3.1
unnamed: J20.6 (C), M3.3
unnamed: J20.5 (D), M3.4
unnamed: J22.8 (A), M4.2 (-)
unnamed: J22.7 (B), M4.1
unnamed: J22.6 (C), M4.3
unnamed: J22.5 (D), M4.4
unnamed: J25.8 (A), M5.2 (-)
unnamed: J25.7 (B), M5.1
unnamed: J25.6 (C), M5.3
unnamed: J25.5 (D), M5.4
unnamed: J26.8 (A), M6.2 (-)
unnamed: J26.7 (B), M6.1
unnamed: J26.6 (C), M6.3
unnamed: J26.5 (D), M6.4

Notes on the sheet:
12.7 mm between pins 2.54mm space between pins PCB traces 0.76mm (2Amps max)

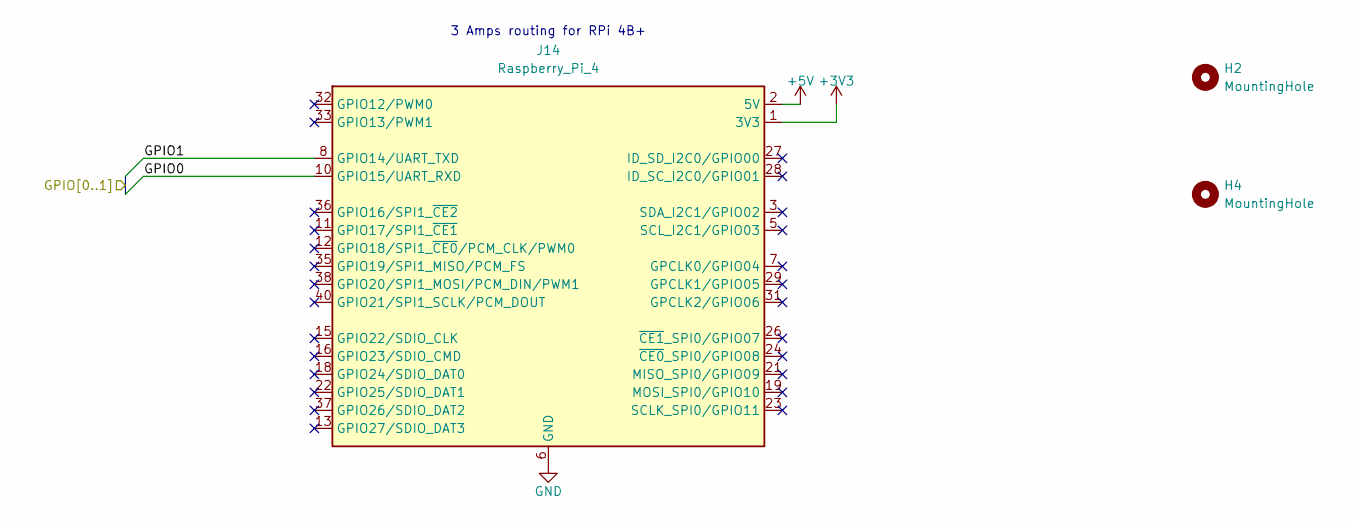
[picture p28: schematic RPi_connection.kicad_sch]

Parts:
H2, H4: MountingHole; MountingHole_3.5mm
J14: Raspberry_Pi_4; PinSocket_2x20_P2.54mm_Vertical_SMD

Connections:
+3V3: J14.1 (3V3), J14.17 (3V3); also elsewhere on the board
+5V: J14.2 (5V), J14.4 (5V); also elsewhere on the board
/MCU/GPIO0: J14.10 (GPIO15/UART_RXD); also elsewhere on the board
/MCU/GPIO1: J14.8 (GPIO14/UART_TXD); also elsewhere on the board
GND: J14.6 (GND), J14.9 (GND), J14.14 (GND), J14.20 (GND), J14.25 (GND), J14.30 (GND), J14.34 (GND), J14.39 (GND); also elsewhere on the board

Notes on the sheet:
3 Amps routing for RPi 4B+

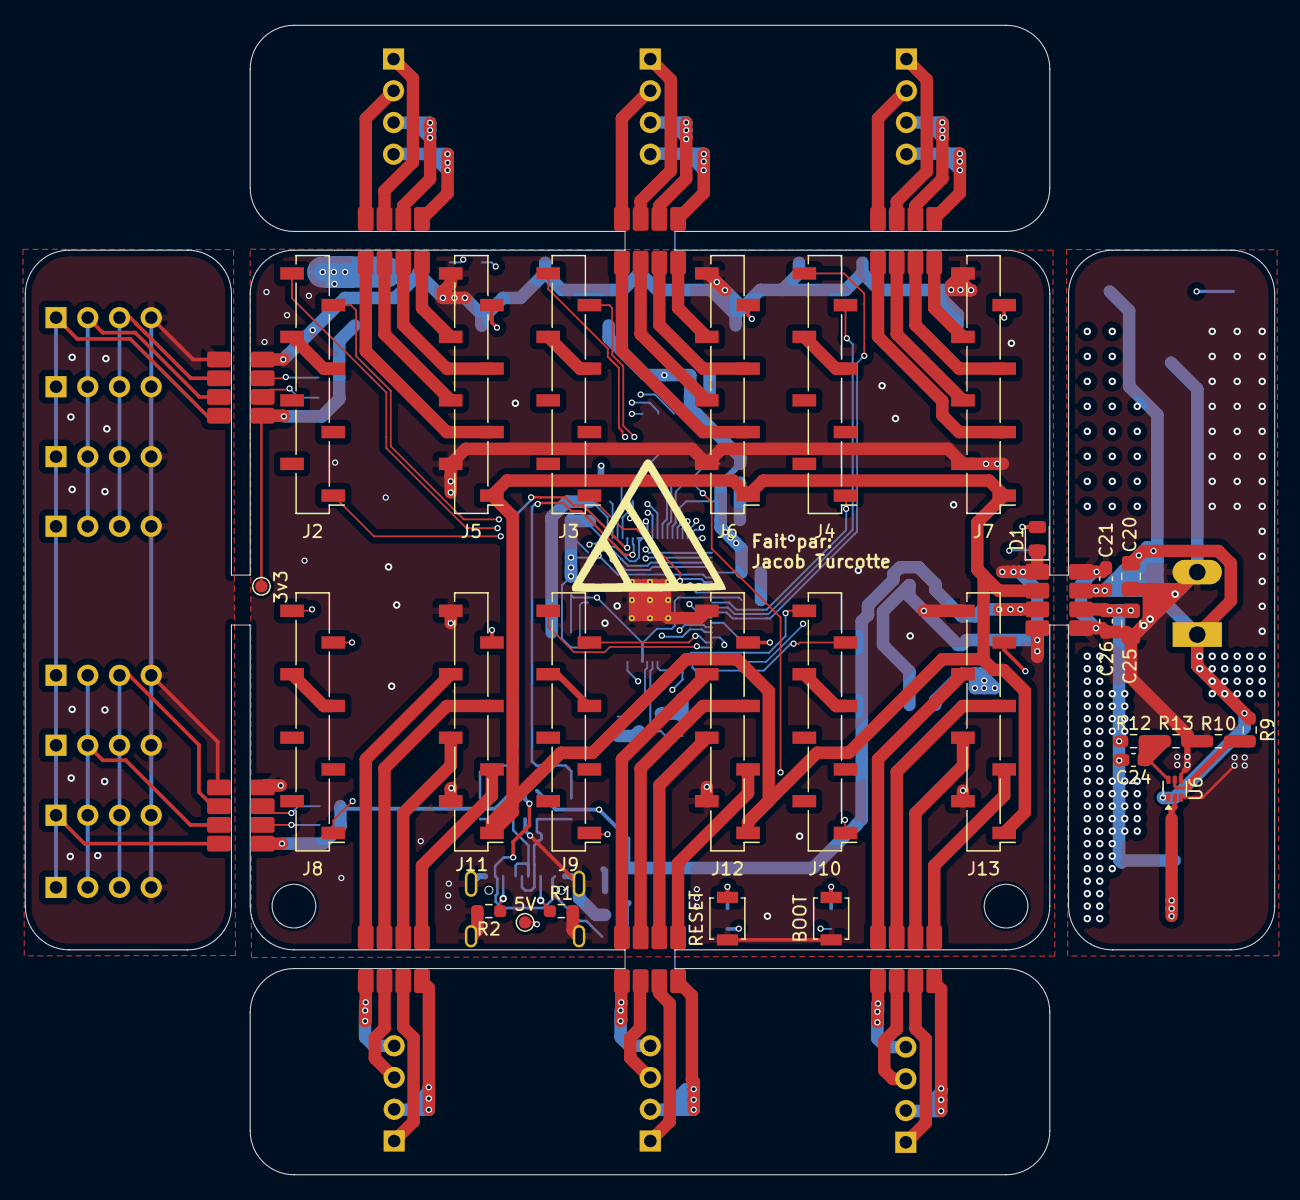
[picture p29: board Cerbrum_Aeris.kicad_pcb from above]

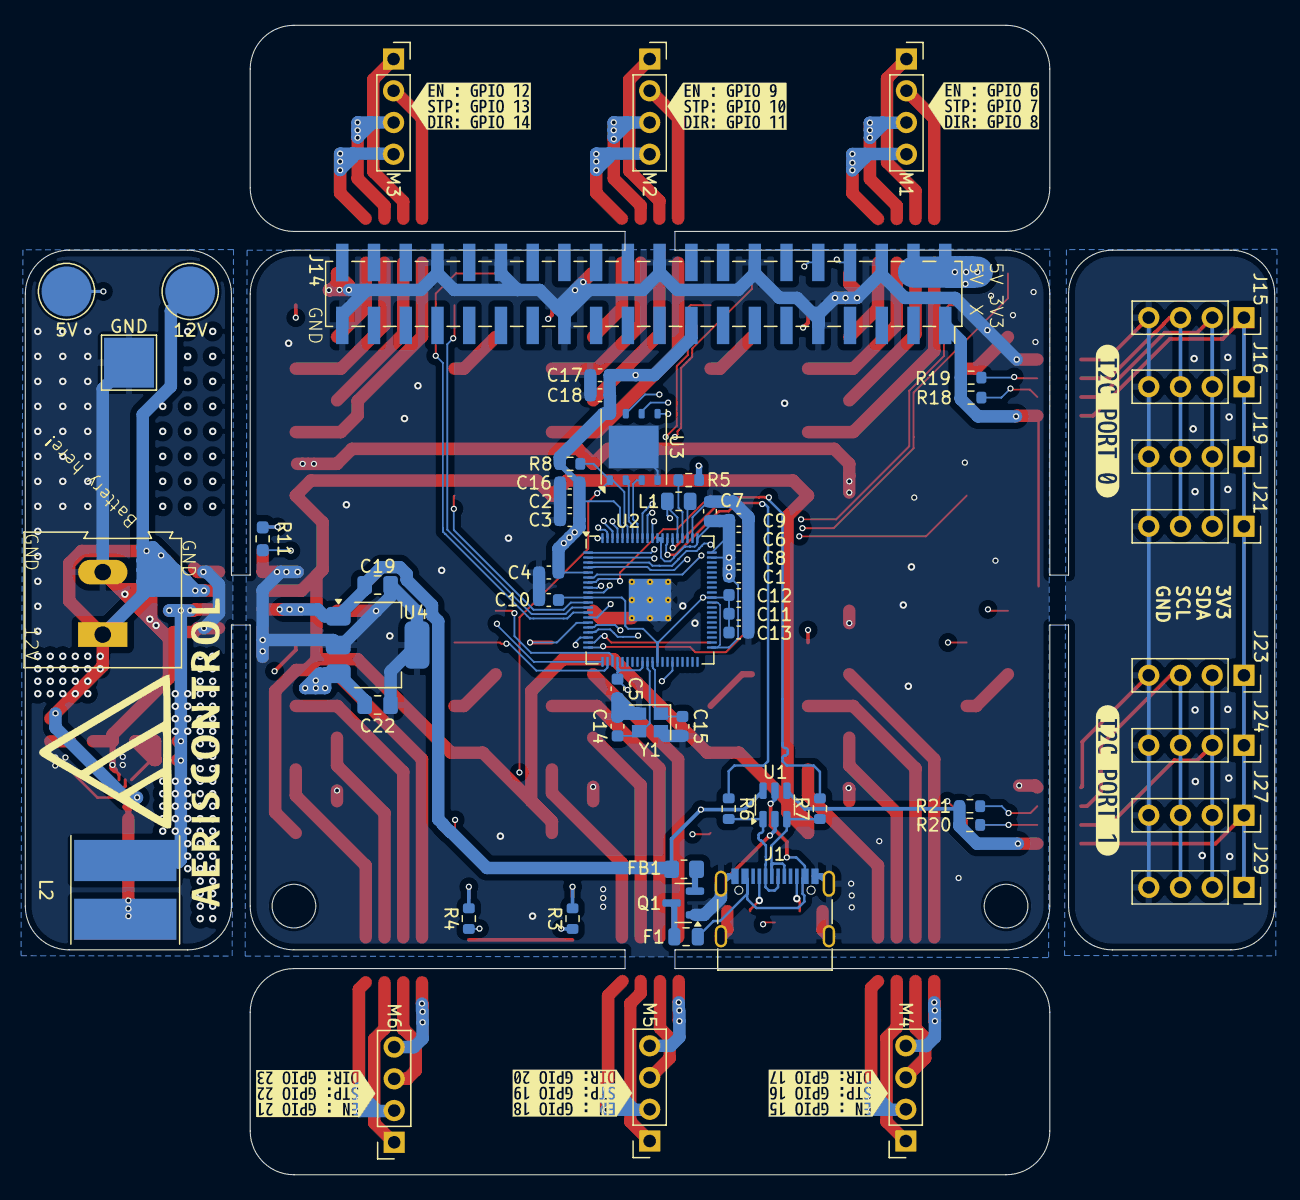
[picture p30: board Cerbrum_Aeris.kicad_pcb from below]

Board: 4 copper layers, 100.0 x 92.0 mm, 109 parts (69 on the bottom side), 117 nets.

Other parts of the board:
3v3: TP_3v3; TestPoint_Pad_D1.0mm
5V: TP_VIN_5V; TestPoint_Pad_D1.0mm
5V#2: TP_5V; TestPoint_Pad_D4.0mm
12V: TP_12V; TestPoint_Pad_D4.0mm
BOOT: SW_BOOTSEL; SW_SPST_B3U-1000P
GND: TP_GND; TestPoint_Pad_4.0x4.0mm
RESET: SW_RESET; SW_SPST_B3U-1000P
kibuzzard-67CE33A5: G***; kibuzzard-67CE33A5
kibuzzard-67CE34A5: G***; kibuzzard-67CE34A5
kibuzzard-67CE320A: G***; kibuzzard-67CE320A
kibuzzard-67CE323D: G***; kibuzzard-67CE323D
kibuzzard-67CE3450: G***; kibuzzard-67CE3450
kibuzzard-67CE3465: G***; kibuzzard-67CE3465
kibuzzard-67CE3487: G***; kibuzzard-67CE3487
kibuzzard-67CE3498: G***; kibuzzard-67CE3498

Their connections:
+3V3: 3v3.1; also elsewhere on the board
+5V: 5V.1; also elsewhere on the board
+5V_ALIM: 5V#2.1; also elsewhere on the board
+12V_BAT: 12V.1; also elsewhere on the board
/MCU/BOOTSEL: BOOT.2 (B); also elsewhere on the board
/MCU/~RESET: RESET.2 (B); also elsewhere on the board
GND: BOOT.1 (A), RESET.1 (A); also elsewhere on the board
GND_ALIM: GND.1; also elsewhere on the board
