Jabooby/Aeris-Control/Code/Rp2350/Stepper_control/A4988_with_PIO_with_class.py

import rp2
import time
from machine import Pin
import ujson
from _thread import allocate_lock

FORWARD = 1
BACKWARD = 0

class StepperControl:
    
    def wait_for_completion(self, sm_irq_state):
        """
        IRQ handler for PIO state machine completion.
        """
        with self.irq_lock:  # Prevent race conditions
            self.irq_flag = True  # Set a flag to indicate completion
            self.inMovement = False
            self.currentStepValue = self.desiredStepValue
        """
        Things I learned: irq is cleared automatically when leaving the handler.
        The print won't work outside the handler and will always show 0
        More info: https://github.com/micropython/micropython/wiki/Hardware-API#irqs 
        """
     

    @rp2.asm_pio(set_init=rp2.PIO.OUT_LOW)
    def stepper_control_step_freq_sm0():
        pull(block)           # Load step count from TX FIFO
        mov(x, osr)           # x contains the number of steps
        pull(block)           # Load delay value from TX FIFO
        
        label("step_loop")
        #y contains the 1/2 of the wanted period
        mov(y, osr)           # Load delay value from OSR into y
        set(pins, 1)          # Set GPIO high
        label("high_delay")
        nop() [31]
        jmp(y_dec, "high_delay")

        mov(y, osr)           # Load delay value from OSR into y
        set(pins, 0)          # Set GPIO low
        label("low_delay")
        nop() [31]
        jmp(y_dec, "low_delay")
        
        jmp(x_dec, "step_loop")  # Continue if x != 0

        irq(0)                   # Raise IRQ to notify CPU when x == 0
        #irq(n) n needs to be equal to the 2^sm_id 
        
    @rp2.asm_pio(set_init=rp2.PIO.OUT_LOW)
    def stepper_control_step_freq_sm1():
        pull(block)           # Load step count from TX FIFO
        mov(x, osr)           # x contains the number of steps
        pull(block)           # Load delay value from TX FIFO
        
        label("step_loop")
        #y contains the 1/2 of the wanted period
        mov(y, osr)           # Load delay value from OSR into y
        set(pins, 1)          # Set GPIO high
        label("high_delay")
        nop() [31]
        jmp(y_dec, "high_delay")

        mov(y, osr)           # Load delay value from OSR into y
        set(pins, 0)          # Set GPIO low
        label("low_delay")
        nop() [31]
        jmp(y_dec, "low_delay")
        
        jmp(x_dec, "step_loop")  # Continue if x != 0

        irq(1)                   # Raise IRQ to notify CPU when x == 0
        #irq(n) n needs to be equal to the 2^sm_id 
        
    @rp2.asm_pio(set_init=rp2.PIO.OUT_LOW)
    def stepper_control_step_freq_sm4():
        pull(block)           # Load step count from TX FIFO
        mov(x, osr)           # x contains the number of steps
        pull(block)           # Load delay value from TX FIFO
        
        label("step_loop")
        #y contains the 1/2 of the wanted period
        mov(y, osr)           # Load delay value from OSR into y
        set(pins, 1)          # Set GPIO high
        label("high_delay")
        nop() [31]
        jmp(y_dec, "high_delay")

        mov(y, osr)           # Load delay value from OSR into y
        set(pins, 0)          # Set GPIO low
        label("low_delay")
        nop() [31]
        jmp(y_dec, "low_delay")
        
        jmp(x_dec, "step_loop")  # Continue if x != 0

        irq(2)                   # Raise IRQ to notify CPU when x == 0
        #irq(n) n needs to be equal to the 2^sm_id 

    def set_step_and_speed(self, step, hz):
        """
        Set the period dynamically based on the desired frequency.
        And sends the amount of steps wanted.
        """
        if(self.inMovement == False):
            self.set_speed(hz)
            self.set_step(step)
        
    def set_speed(self, hz):
        """
        Set the period dynamically based on the desired frequency.
        """
        self.speed = hz
        
    def set_direction(self, dir):
        """
        Set the direction pin according to wanted direction
        """
        self.dirPin.value(dir)
        
    def set_step(self, step):
        """
        Set the direction according to the value step received.
        Sends the number of steps wanted to the SM with the required speed.
        Stores all necessary data for logging later.
        """
        if(step < 0):
            self.set_direction(BACKWARD)#negative value goes backward
        else:
            self.set_direction(FORWARD) #positive value goas forward
        self.sm.put(abs(step))          #Send the number of steps to the SM
        self.desiredStepValue += step   #Store the desired position 
        #Better way to do this is to do the math whenever the speed is changed and store it
        half_period_cycles = int(self.clock_freq / (50 * self.speed))  # Calculate half-period in clock cycles
        self.sm.put(half_period_cycles) #Send the delay value to the PIO state machine
        self.inMovement = True          #SM is occupied and should not be communicated with till it is done. Not yet implemented...
    
    def reset_motor(self):
        """
        Reset the motorZ by reactivating the state machine and clearing any previous settings.
        """
        self.stop_motor()
        time.sleep(0.1)  # Short delay to ensure state machine stops
        self.sm.active(1)  # Reactivate the state machine
        self.desiredStepValue = 0
        self.currentStepValue = 0
        print("motorZ reset.")

    def stop_motor(self):
        """
        Stop the motorZ. More specifically, stops the state machine.
        """
        self.sm.active(0)  # Stop the state machine
        
    def start_motor(self):
        """
        Start the motorZ. More specifically, starts the state machine.
        """
        self.sm.active(1)  # Stop the state machine
        
    def change_pin(self, stpPin, dirPin):
        """
        Change the GPIO pin used by the state machine.
        """
        self.stpPin = Pin(stpPin, Pin.OUT)
        self.dirPin = Pin(dirPin, Pin.OUT)
        
        self.stop_motor()
        self.sm = rp2.StateMachine(sm_id, self.stepper_control_step_freq, freq=self.clock_freq, set_base=self.stpPin)
        self.start_motor()
        
        print(f"GPIO pin changed to {self.pin}.")
        
    def state_as_json(self):
        """
        Return the state of the instance variables in JSON format.
        """
        state = {
            "stpPin": self.stpPin,
            "dirPin": self.dirPin,
            "clock_freq": self.clock_freq,
            "inMovement": self.inMovement,
            "desiredStepValue": self.desiredStepValue,
            "currentStepValue": self.currentStepValue,
            "speed": self.speed,
            "state_machine_id": self.sm_id,
            "irq_status": self.sm.irq().flags() if self.sm else None
        }
        
        return state
    
    def go_to_position(self, position):
        if(self.inMovement == False):
            stepsNeeded = position - self.currentStepValue
            self.set_step(stepsNeeded)
        
    def __init__(self, sm_id, stpPin, dirPin, clock_freq=150_000_000):
        self.stpPin = Pin(stpPin, Pin.OUT)
        self.dirPin = Pin(dirPin, Pin.OUT)
        self.clock_freq = clock_freq
        

        
        self.sm_id = sm_id
        if sm_id == 0:
            self.sm = rp2.StateMachine(
            sm_id,
            self.stepper_control_step_freq_sm0,
            freq=self.clock_freq,
            set_base=self.stpPin,
            )
        elif sm_id == 1:
            self.sm = rp2.StateMachine(
                sm_id,
                self.stepper_control_step_freq_sm1,
                freq=self.clock_freq,
                set_base=self.stpPin,
                )
        else:
             self.sm = rp2.StateMachine(
                sm_id,
                self.stepper_control_step_freq_sm4,
                freq=self.clock_freq,
                set_base=self.stpPin,
                )
             
        self.sm.irq(handler=self.wait_for_completion)
        self.irq_flag = False  # Initialize flag
        self.irq_lock = allocate_lock()
        
        self.start_motor()
        self.sm.irq(handler = self.wait_for_completion)
        
        self.dir = FORWARD
        self.set_direction(dir)
        
        self.inMovement = False
        self.speed = 0
        self.desiredStepValue = 0
        self.currentStepValue =  0
        
# Example usage:
if __name__ == "__main__":
    motorZ = StepperControl(sm_id=0, stpPin=14, dirPin=15)
    motorL = StepperControl(sm_id=1, stpPin=16, dirPin=17)

    motorZ.set_step_and_speed(1200,300)  # Set initial frequency to 300 Hz
    motorL.set_step_and_speed(300,310)  # Set initial frequency to 300 Hz
    #motorZ.wait_for_completion()
    while not motorZ.irq_flag or not motorL.irq_flag:
        time.sleep(0.1)  # Small delay to prevent CPU overload

    motorZ.irq_flag = False  # Reset flag
    motorL.irq_flag = False  # Reset flag
    print("Step sequence complete!")


    #print(motorZ.state_as_json())
    print("First step sequence complete!")
    print(motorZ.state_as_json())
    print(motorL.state_as_json())
    
    motorZ.set_step_and_speed(-1200,300)  # Set frequency to 900 Hz
    motorL.set_step_and_speed(-600,310)  # Set initial frequency to 300 Hz
    #motorZ.wait_for_completion()
    while not motorZ.irq_flag or not motorL.irq_flag:
        time.sleep(0.1)  # Small delay to prevent CPU overload

    motorZ.irq_flag = False  # Reset flag
    motorL.irq_flag = False  # Reset flag
    print("Step sequence complete!")


    print("Second step sequence complete!")
    print(motorZ.state_as_json())
    print(motorL.state_as_json())

    # Reset the motorZ
    motorZ.reset_motor()
    motorL.reset_motor()
