Jabooby/Aeris-Control/(commit log)

2025-01-29 push élec presque terminé
    [Aeris control electrical plans.kicad_sch]
2025-02-05 Push motor code
    [Aeris control electrical plans.kicad_sch]
2025-02-05 push code for sensor AS5600 and updates to BMI160
2025-02-05 upload 3D
    [Bracket Tail-Leach.stl, Echangeur.stl, Lightweight mast attachement for rope.stl, Mast_Attachement_Rope.stl, Middle_Mast_Crow_Nest_Assembly.stl, Poulie.stl, Support a poulie + Angle.stl, Support a poulie - Angle.stl]
2025-02-06 push test
    je vais faire un répertoire /lib bientot que on aura juste à copy paste dans le pico plus tard
2025-02-11 push BMI160, UART and BMI160
2025-02-14 IMU read
2025-02-19 Add files via upload
    IMU fonctionnel
2025-02-23 Push schéma électrique + pdf
    [Aeris control electrical plans.kicad_sch]
2025-02-23 Push PNG and PDF for stepper motor class
2025-03-01 Mega push elect
    [A4988_STEPPER_MOTOR_DRIVER_CARRIER.step, Aeris control electrical plans.kicad_pcb, Aeris control electrical plans.kicad_sch, Cerbrum_Aeris.kicad_pcb, Cerbrum_Aeris.kicad_sch, MCU.kicad_sch, Power.kicad_sch, RP2350A-QFN60.step]
2025-03-04 push éelectrique pcb
    [Cerbrum_Aeris.kicad_pcb, Cerbrum_Aeris.kicad_sch, MCU.kicad_sch, Power.kicad_sch, RPi_connection.kicad_sch, Sensors.kicad_sch, Steppers.kicad_sch]
2025-03-12 push pcb
    [Cerbrum_Aeris.csv, Cerbrum_Aeris.kicad_pcb]
2025-04-01 push kicad erreurs
    [MCU.kicad_sch]
2025-04-02 pico push
2025-04-02 mech assemblage principale
2025-04-02 Bonnes pin pour le i2c avec le pico à Brampton
2025-04-05 pid code for orientation, needs to be tested and configured
2025-04-09 new handler for imu
2025-04-09 Code pour la windvane pas mal finit, cde pour anemometer in progress
